Muellegr/Star_Gazer/Case/Pictures/CaseCutout_SimpleSide.png

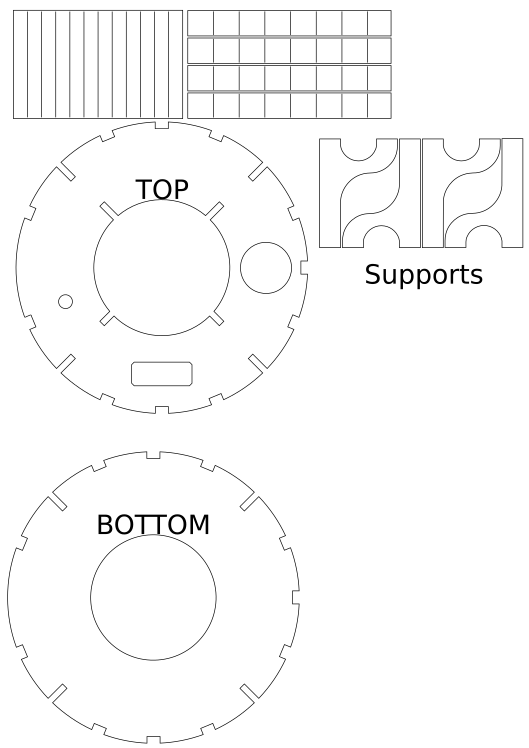
Case/Pictures/CaseCutout_SimpleSide.png
