Muellegr/Star_Gazer/Case/Pictures/IMG_20201006_191345.jpg

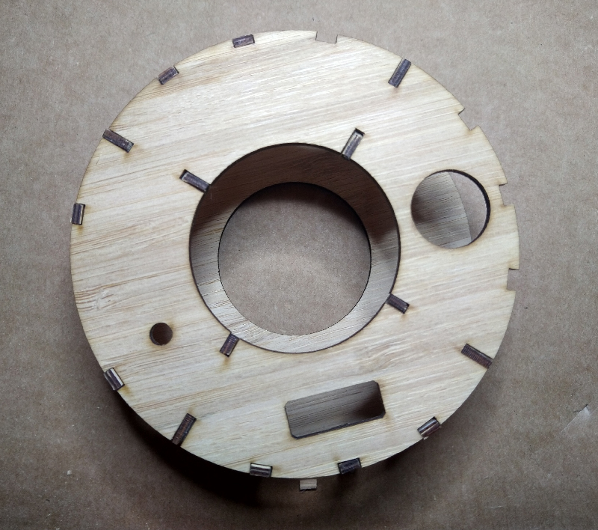
Case/Pictures/IMG_20201006_191345.jpg
