Muellegr/Star_Gazer/Case/Pictures/IMG_20201006_191352.jpg

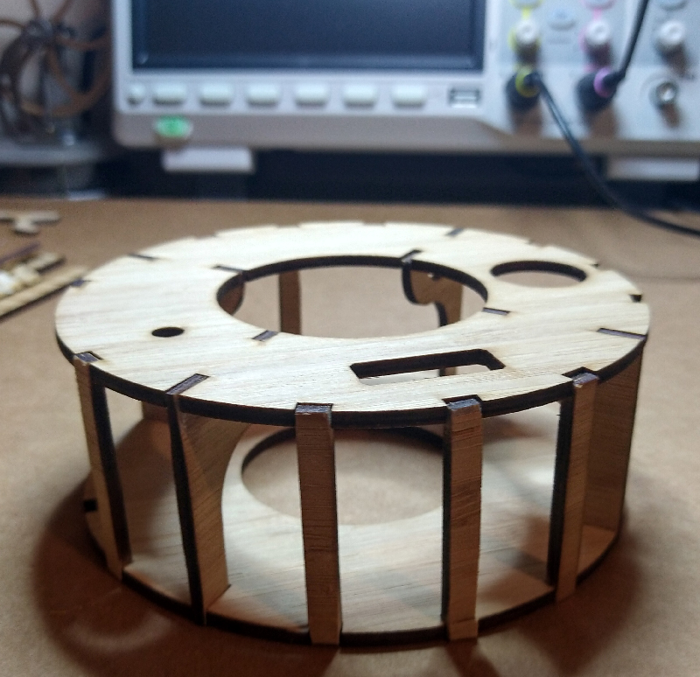
Case/Pictures/IMG_20201006_191352.jpg
