Muellegr/Star_Gazer/Documentation/Images/PCB Blank/IMG_20201009_194849.jpg

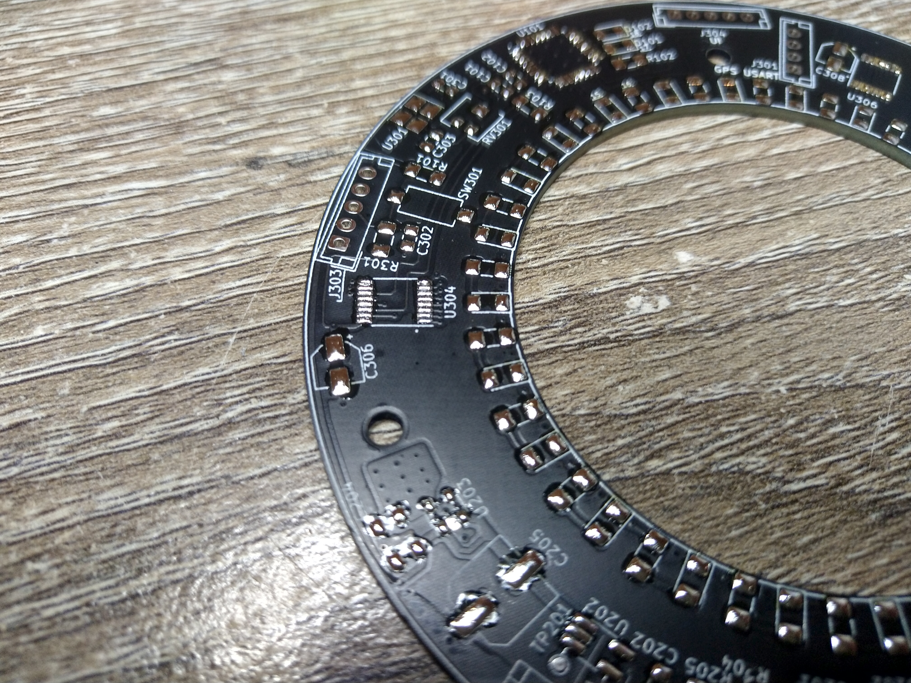
Documentation/Images/PCB Blank/IMG_20201009_194849.jpg
