Muellegr/Star_Gazer/Documentation/Images/PCB Blank/IMG_20201009_195733.jpg

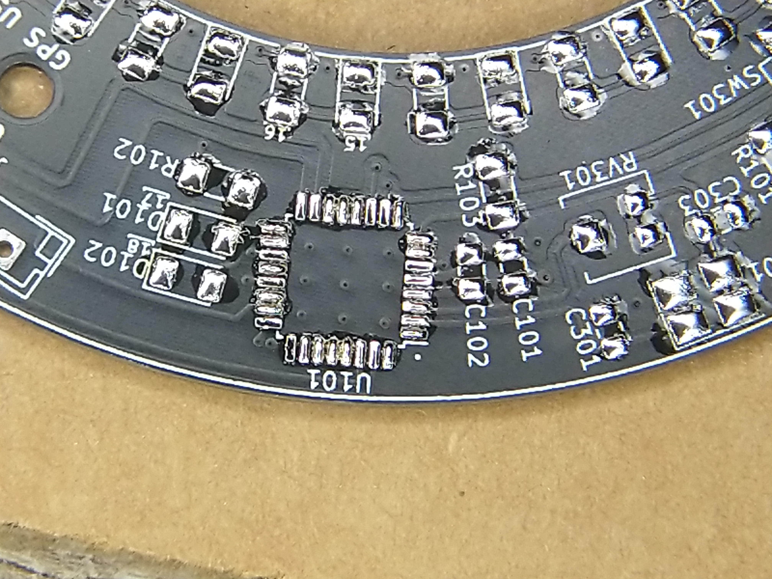
Documentation/Images/PCB Blank/IMG_20201009_195733.jpg
