Muellegr/Star_Gazer/Documentation/Images/PCB DESIGN/PCB_PLACEMENT_0.png

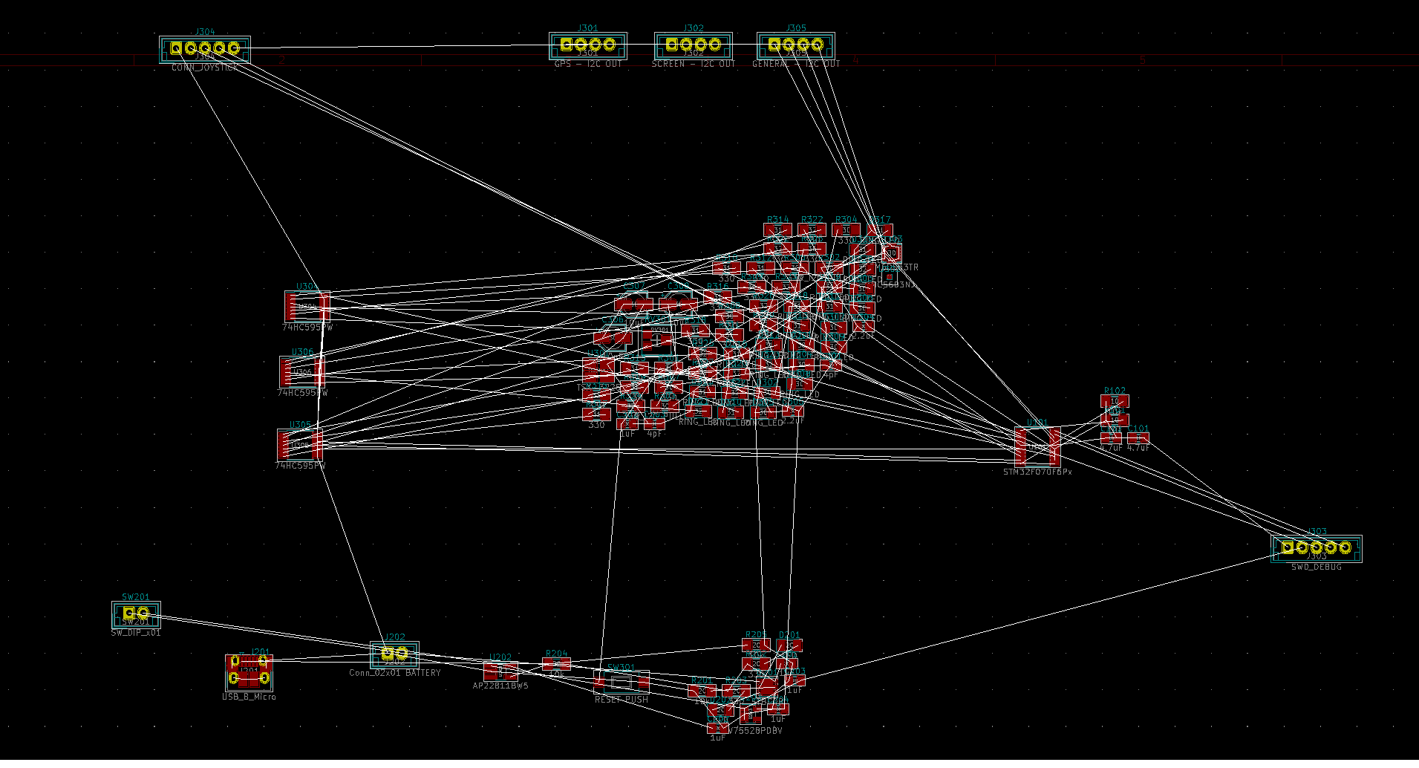
Documentation/Images/PCB DESIGN/PCB_PLACEMENT_0.png
