Muellegr/Star_Gazer/Documentation/Images/PCB DESIGN/PCB_PLACEMENT_1.png

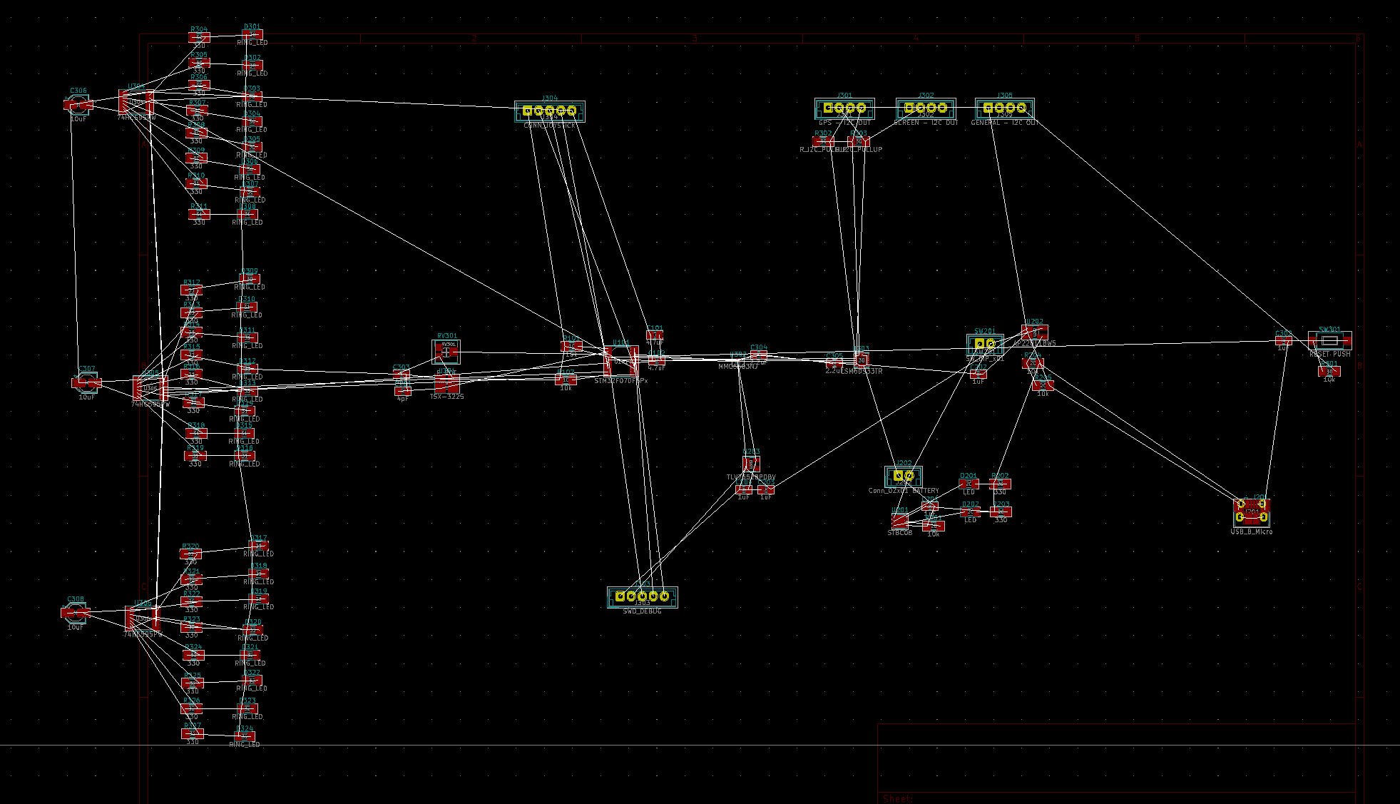
Documentation/Images/PCB DESIGN/PCB_PLACEMENT_1.png
