Muellegr/Star_Gazer/Documentation/Images/PCB DESIGN/PCB_PLACEMENT_RING.png

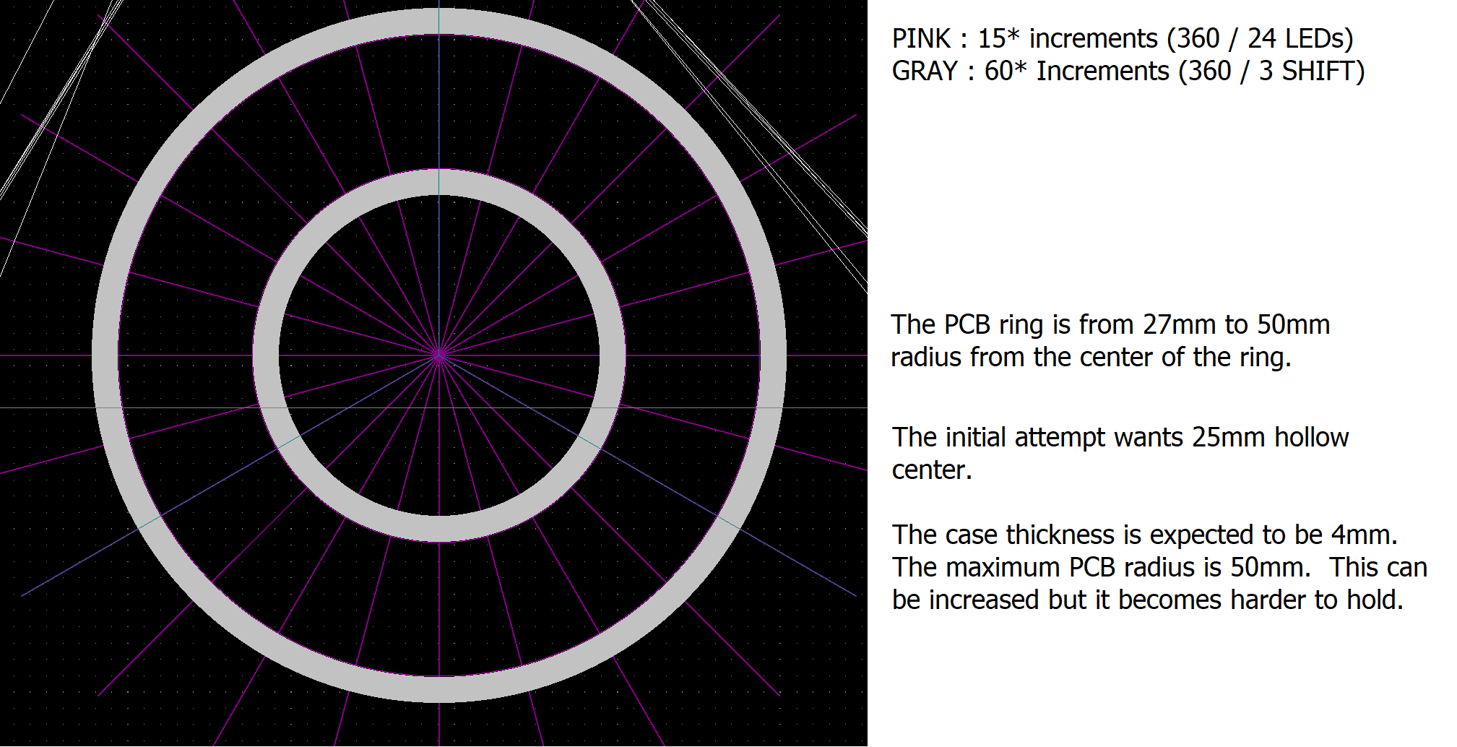
Documentation/Images/PCB DESIGN/PCB_PLACEMENT_RING.png
