Muellegr/Star_Gazer/Documentation/Images/PCB Melt/IMG_20201010_125346.jpg

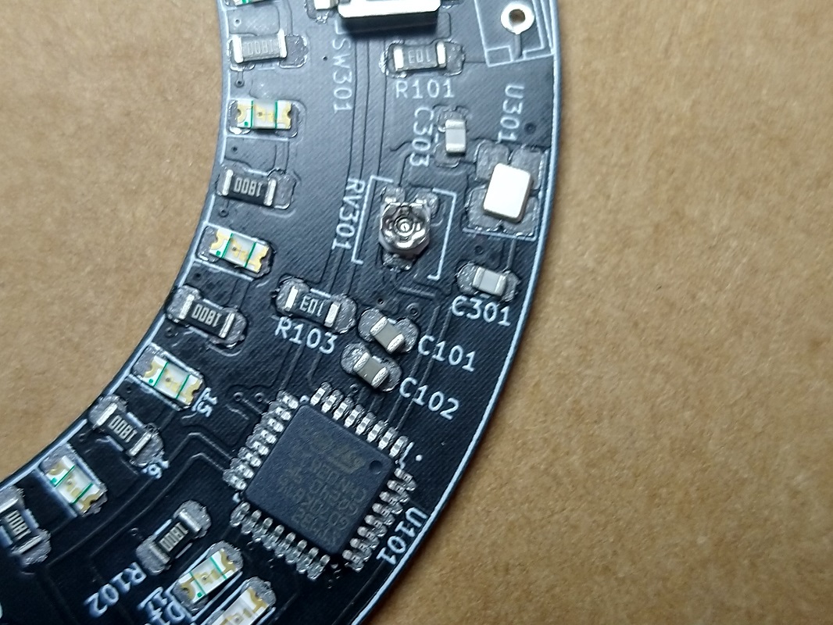
Documentation/Images/PCB Melt/IMG_20201010_125346.jpg
