Muellegr/Star_Gazer/Case/Pictures/Case_Failure.png

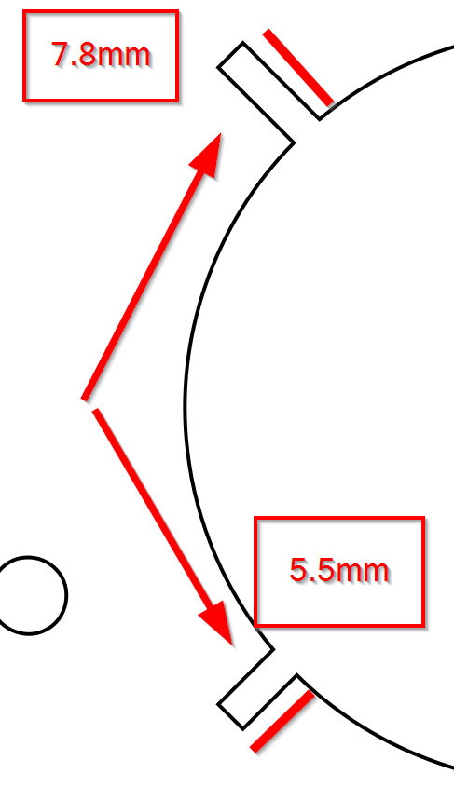
Case/Pictures/Case_Failure.png
