Muellegr/Star_Gazer/(threads)

Thread 1 (2020-09-07):

Feedback

ZachEnglish, 2020-09-07:
Battery Charging
LEDs at maximum current can sometimes be brighter than you desire (also take up more power for a battery powered device).
Especially for a device designed to be used at night, suggest testing out R values for R202 to observe brightness before commiting to a value.
Easy to swap later if it is an issue though.

Shift Registers
If you run a line from the output enable on the shift registers to a free I/O pin (didn't check to see if you have spare...), you could PWM your LEDs all at once that way. This loops to the comment earlier about LED brightness.

Magnometer
I think you have the power and ground pins backwards. VSA should be ground and VDD is power.

Microcontroller
There is a lot to dig into here and I haven't yet at all. Is the part you have in your schematic the same one you have a link to in your planning document?

Muellegr, 2020-09-08:
The battery charging LEDs will only be on when inside a building and connected to a proper power source.  Since they'll be inside a container with a sort of ribbed side, I want them to be bright enough to easily see.

I was going to wing the LED brightness, but now I wonder if I could get a good test in before I order parts.

Shift Register - Using output enable like that wasn't something I thought about.  The plan was to originally run the LEDs bright but keep them off most of the time.  I moved 'reset' over to a io pin so I could quickly turn it off.  I think using output enable is an upgrade if I can't find any negatives with it!

Magnometer - I'll have to double check.  I think I noticed that myself earlier and fixed it, though that may have been the crystal.  One of the tiny 4 square things.

MC - Oh boy that planning document is not the greatest.  I've moved over to tracking parts entirely within kicad, which is the same thing as on the wiki page.

The chip I'm using is the 'STM32F070F6P6TR'.  When I was initially planning things out I bounced between a bunch of different cortex chips as I slowly got a grasp on them. Decision paralysis got ahold of me so I went with the first chip I found that would do the job.

---
The schematic and part IDs are probably in their final form unless I find a mistake.  Big todo is to go in with a fine tooth comb on my power side and look for problems, polish info on what/why I did things here (otherwise I never will) and continue working on the layout.
