Muellegr/Star_Gazer/Documentation/StarGazer_Schematics.pdf

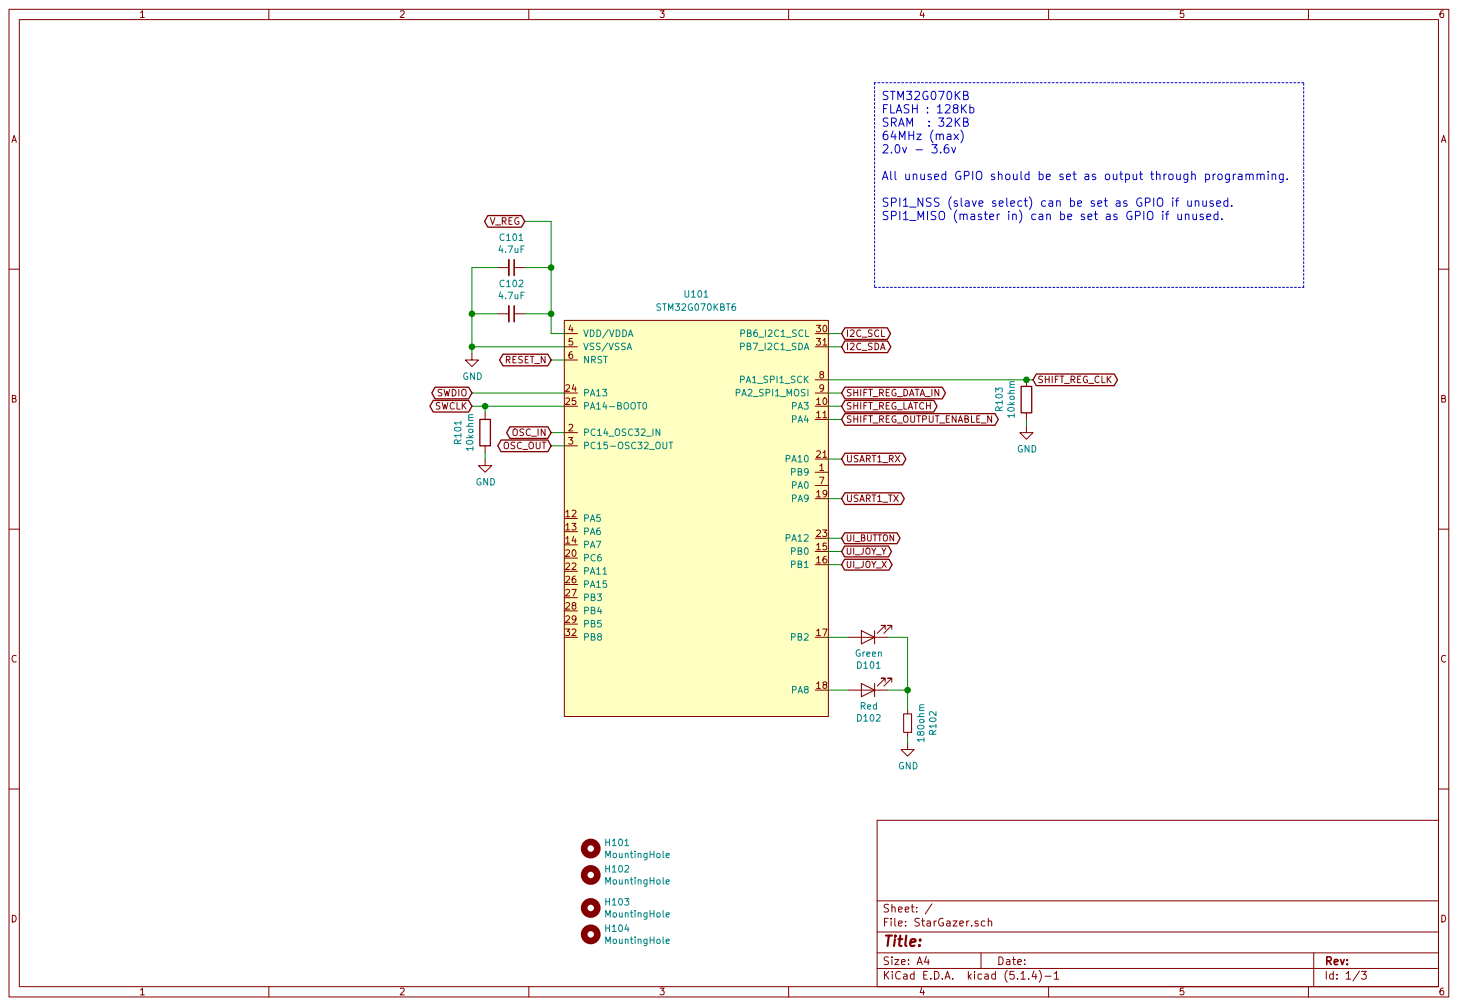
[picture p16: page 1]

All unused GPIO should be set as output through programming.

SPI1_NSS (slave select) can be set as GPIO if unused.
SPI1_MISO (master in) can be set as GPIO if unused.

Id: 1/3 Title: File: StarGazer.sch Sheet: /

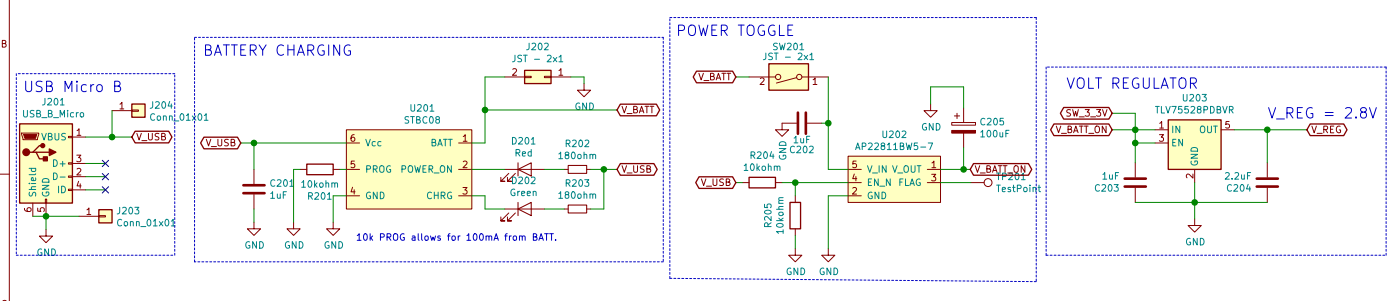
[picture p17: page 2]

10k PROG allows for 100mA from BATT. USB Micro B

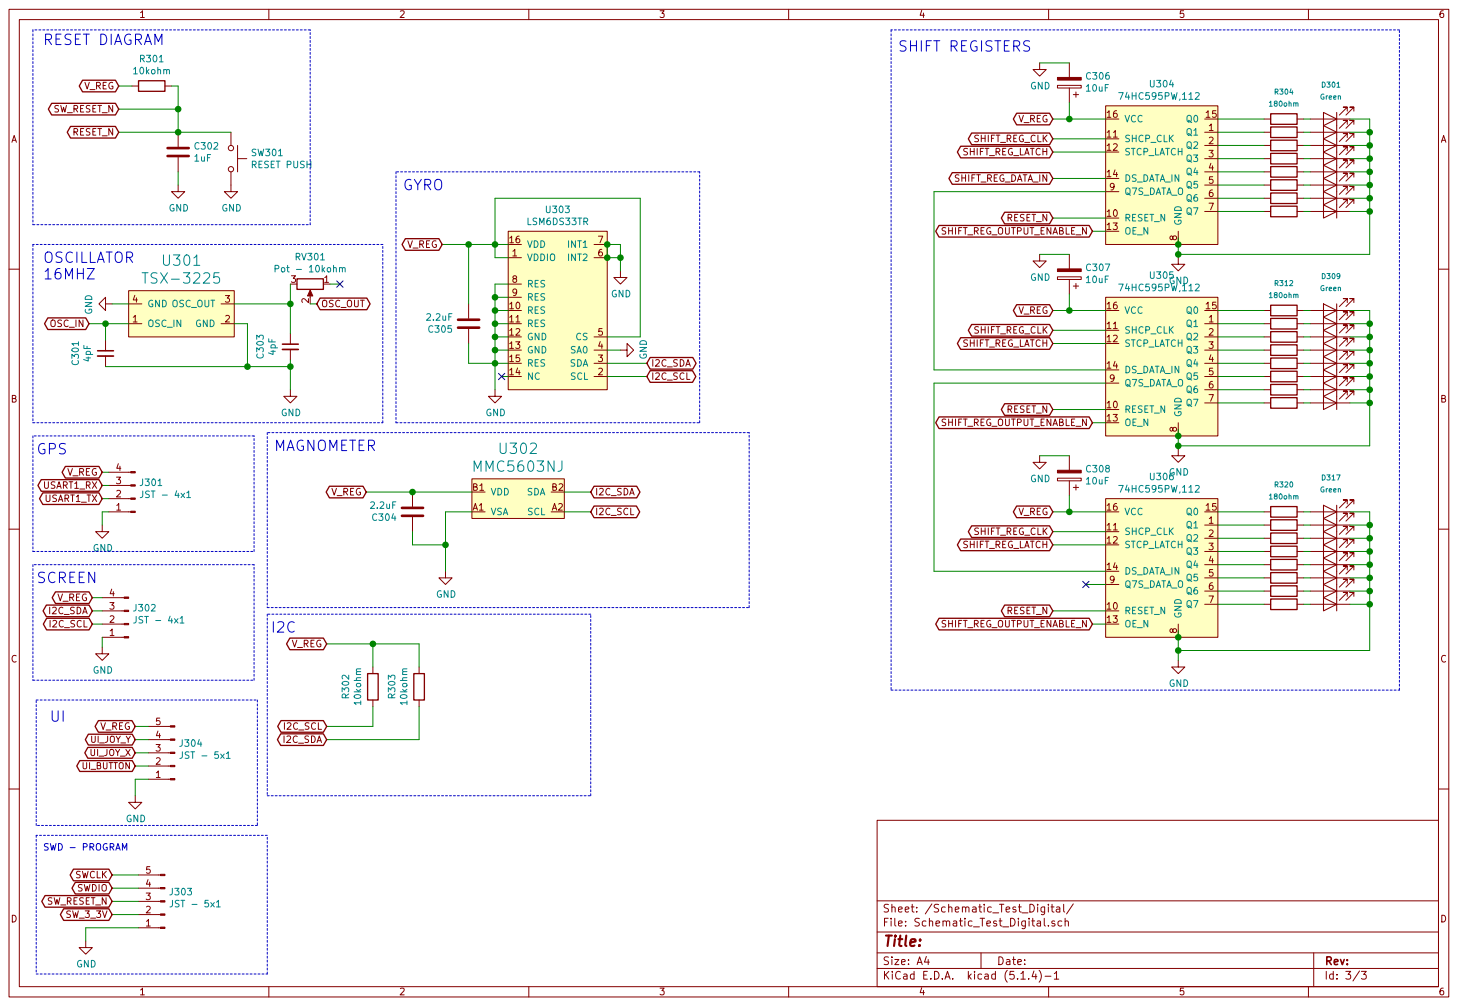
[picture p18: page 3]
