Muellegr/Star_Gazer/Documentation/StarGazer-B_CrtYd.pdf

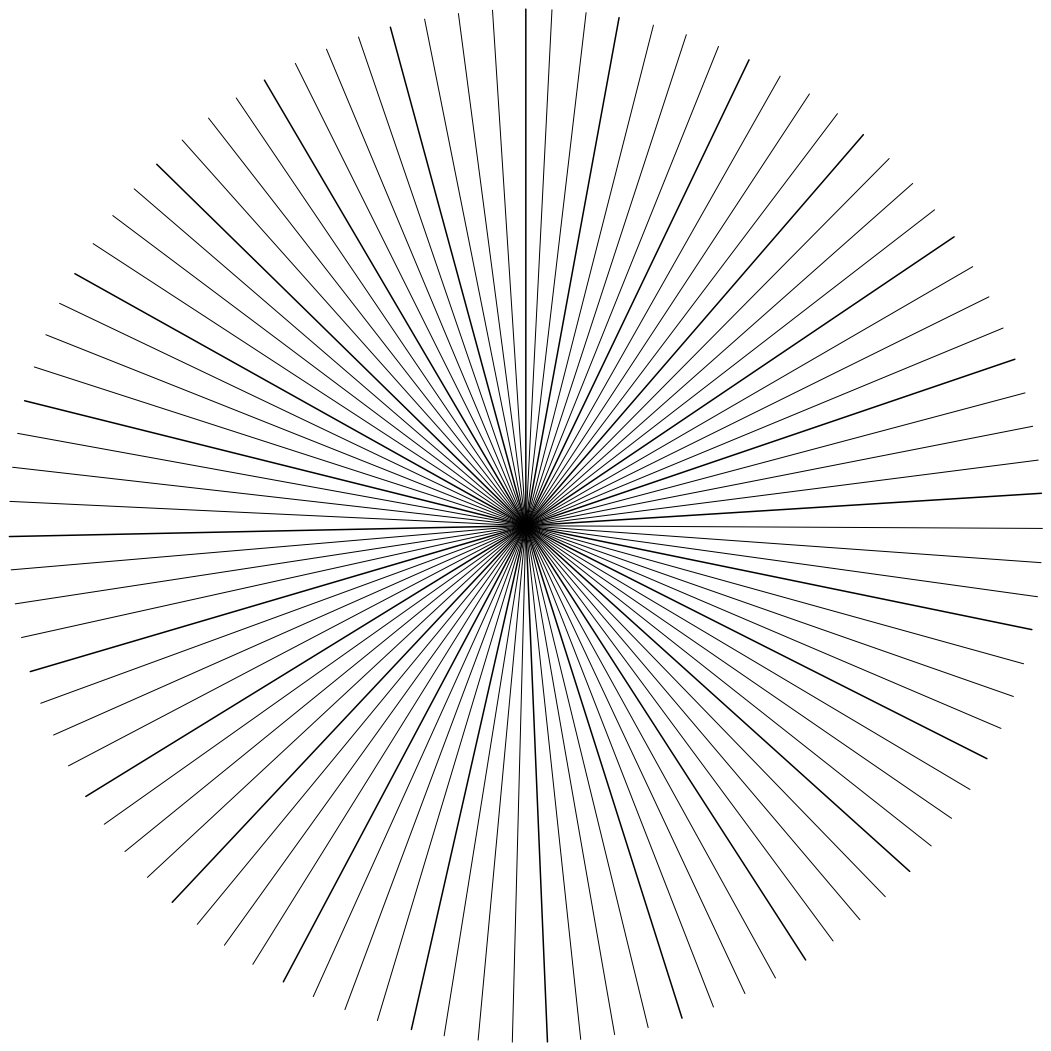
[picture p19: page 1]
