Muellegr/Star_Gazer/Documentation/StarGazer-B_Mask.pdf

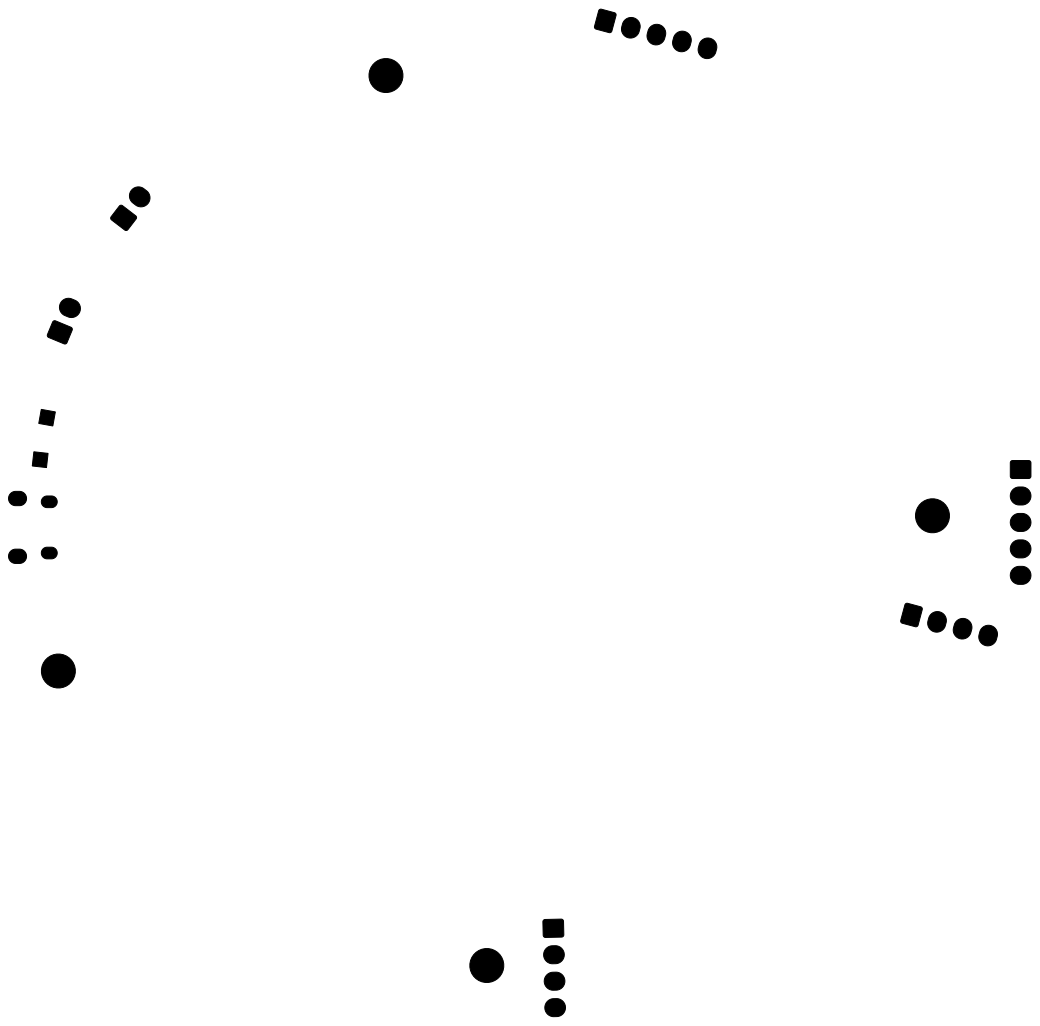
[picture p20: page 1]
