Muellegr/Star_Gazer/Documentation/StarGazer-B_SilkS.pdf

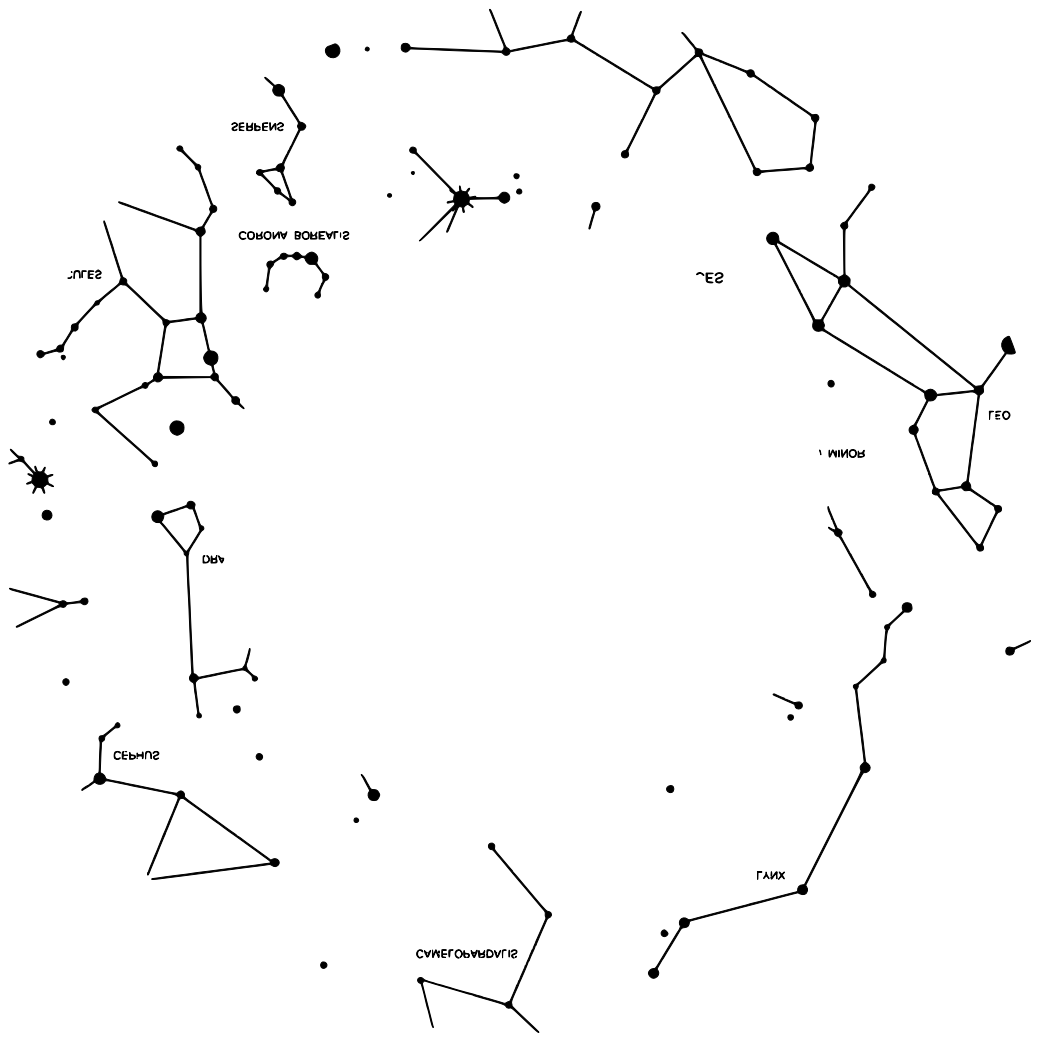
[picture p21: page 1]
