Muellegr/Star_Gazer/Documentation/StarGazer-Back.pdf

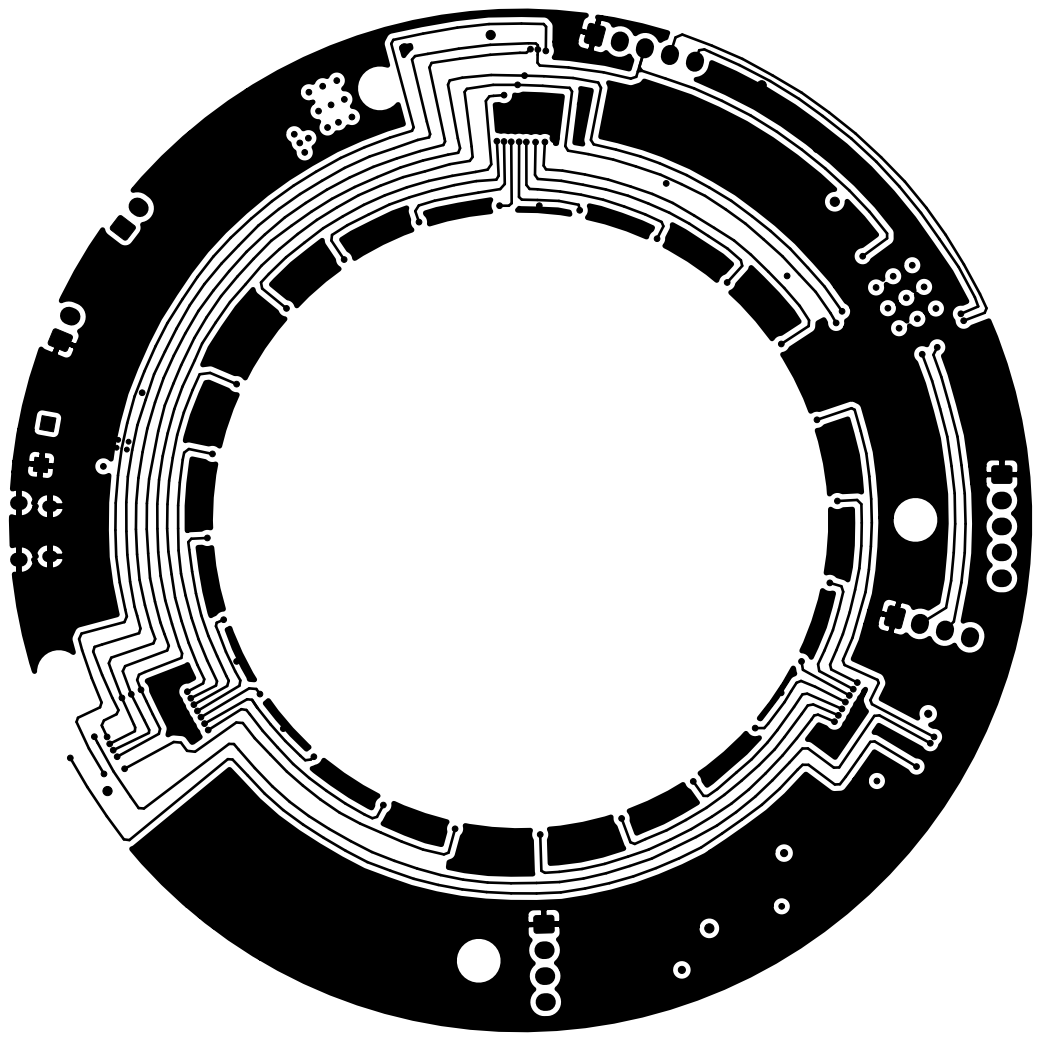
[picture p22: page 1]
