Muellegr/Star_Gazer/Documentation/StarGazer-F_CrtYd.pdf

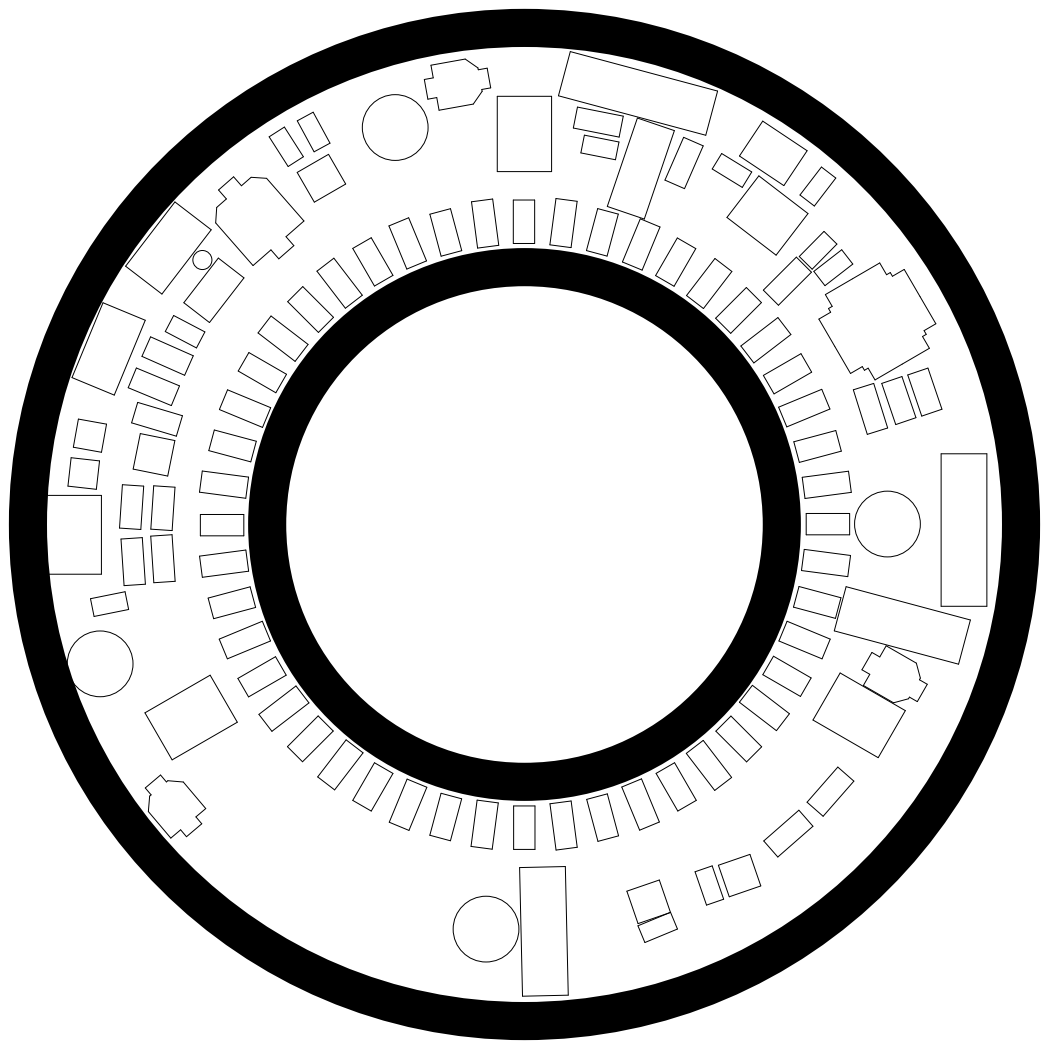
[picture p23: page 1]
