Muellegr/Star_Gazer/Documentation/StarGazer-F_Mask.pdf

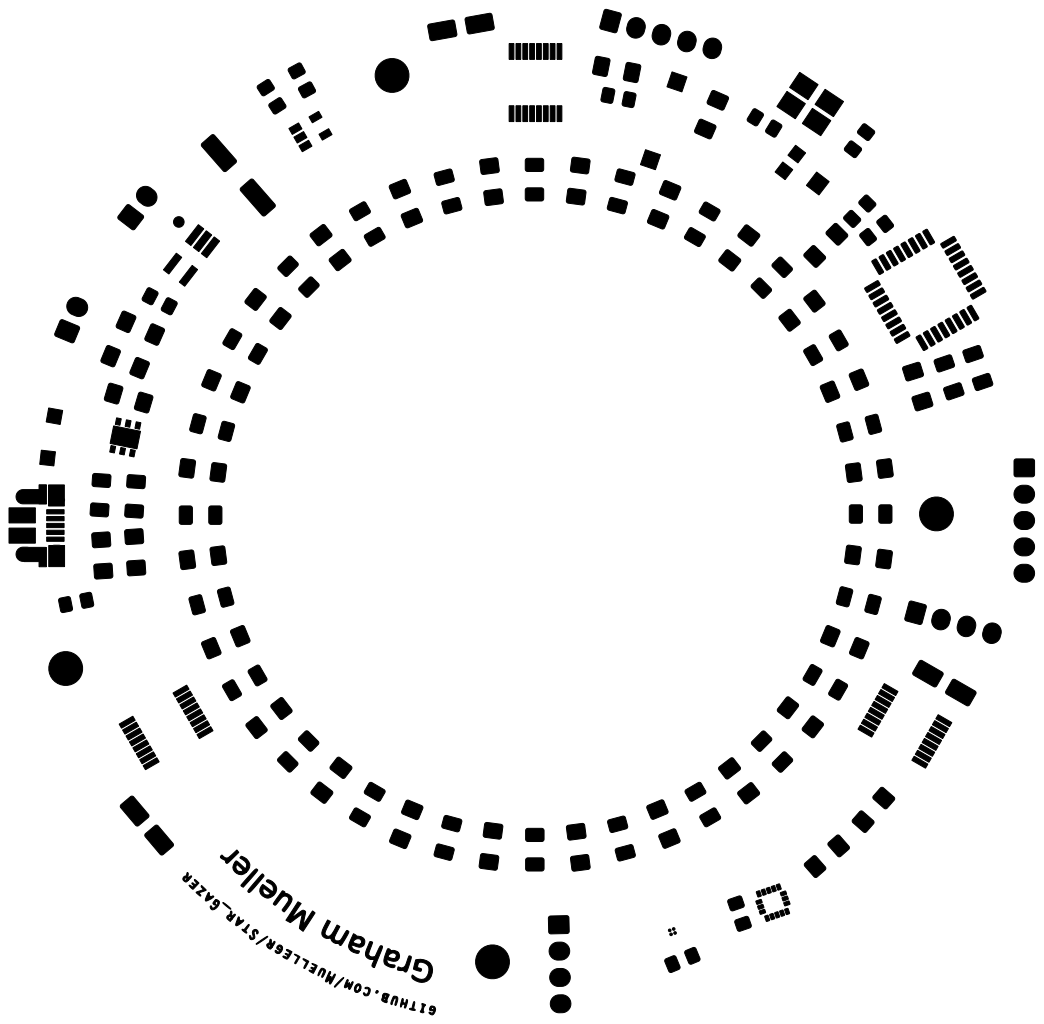
[picture p24: page 1]
