Muellegr/Star_Gazer/Documentation/StarGazer-F_Paste.pdf

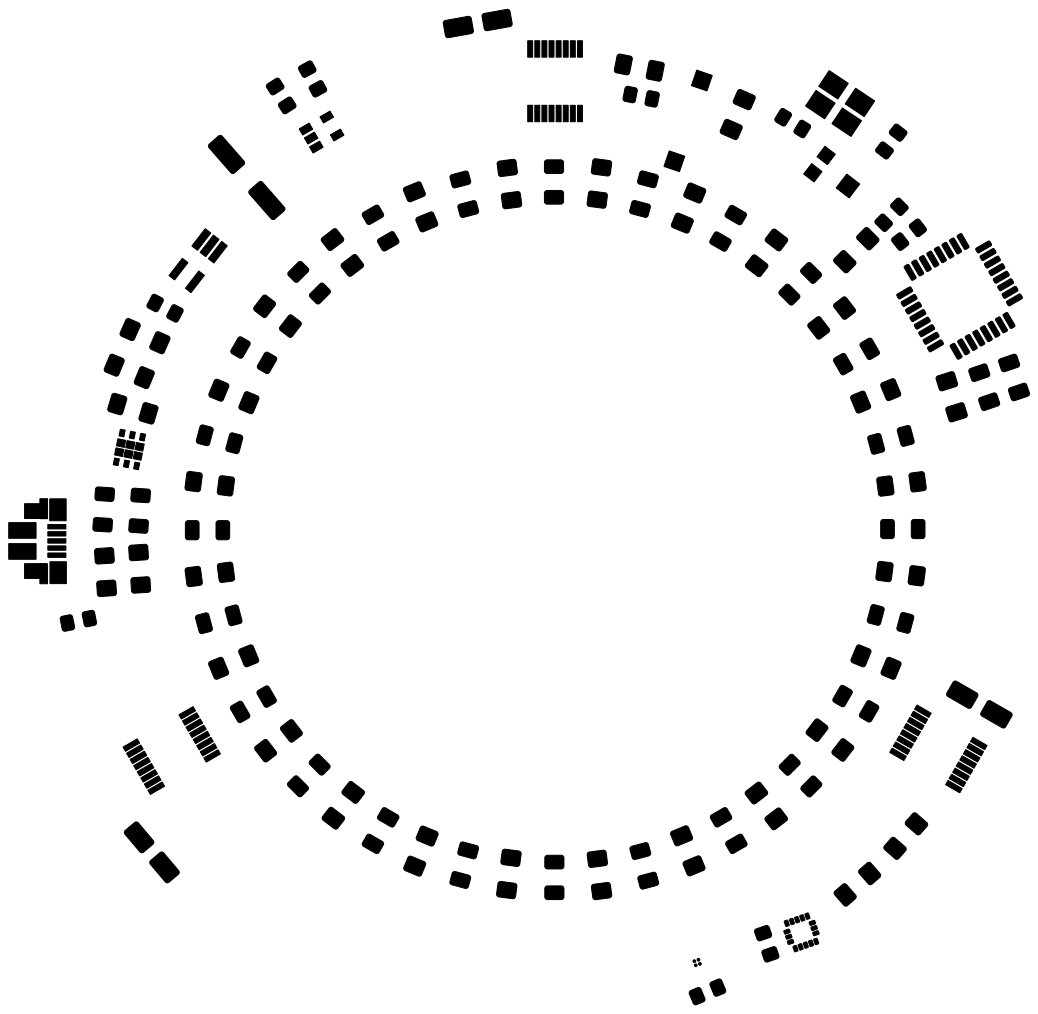
[picture p25: page 1]
