Muellegr/Star_Gazer/Documentation/StarGazer-F_SilkS.pdf

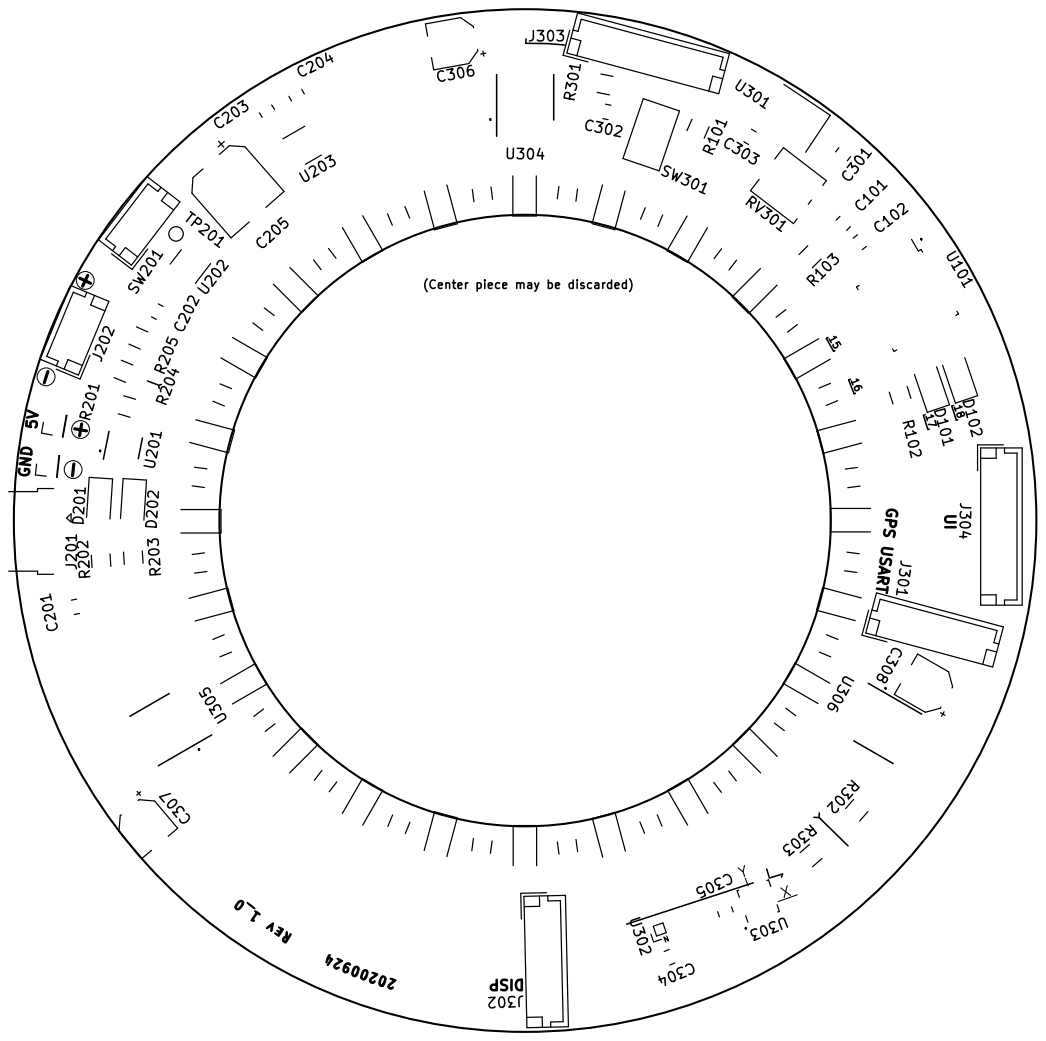
[picture p26: page 1]
