Muellegr/Star_Gazer/Documentation/StarGazer-Front.pdf

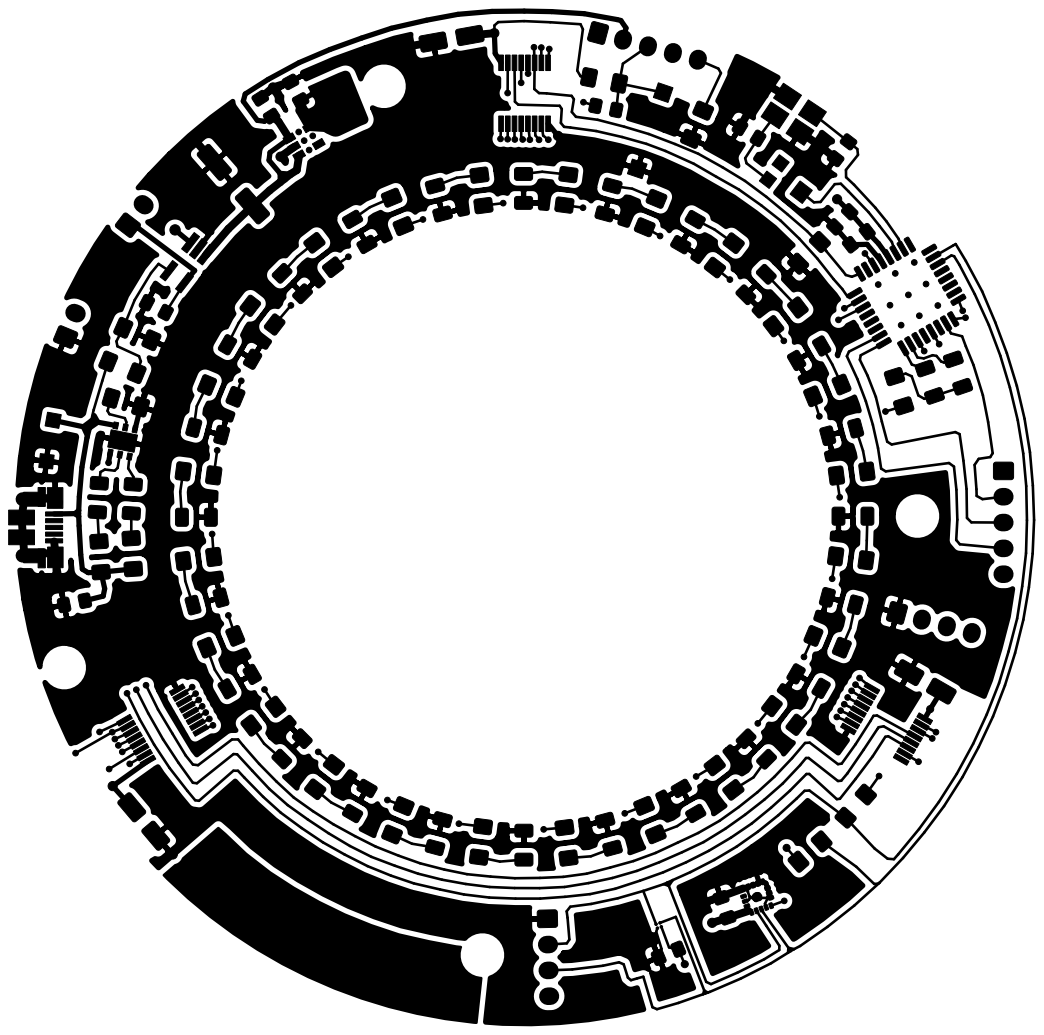
[picture p27: page 1]
