Muellegr/Star_Gazer/Documentation/StarGazer-In1_Cu.pdf

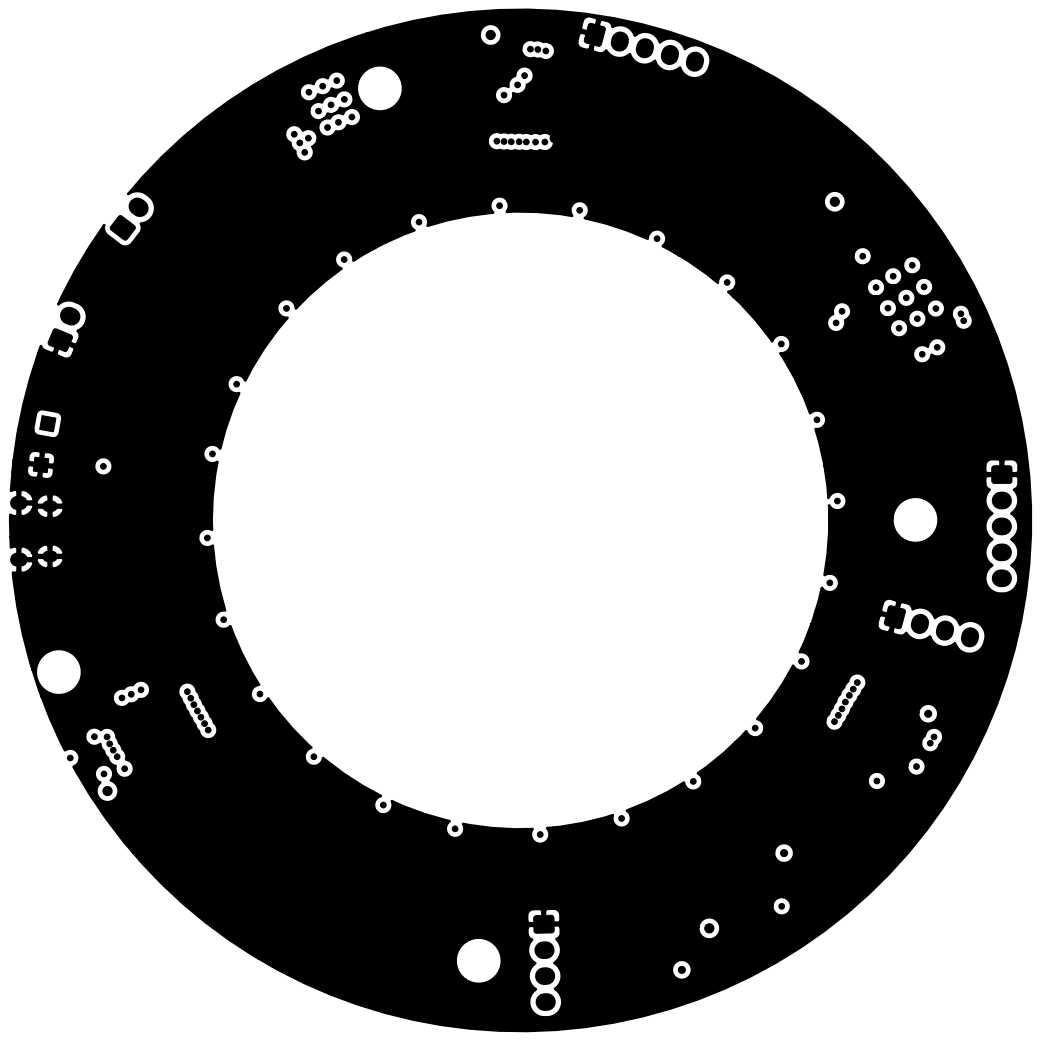
[picture p28: page 1]
