Muellegr/Star_Gazer/Documentation/StarGazer-In2_Cu.pdf

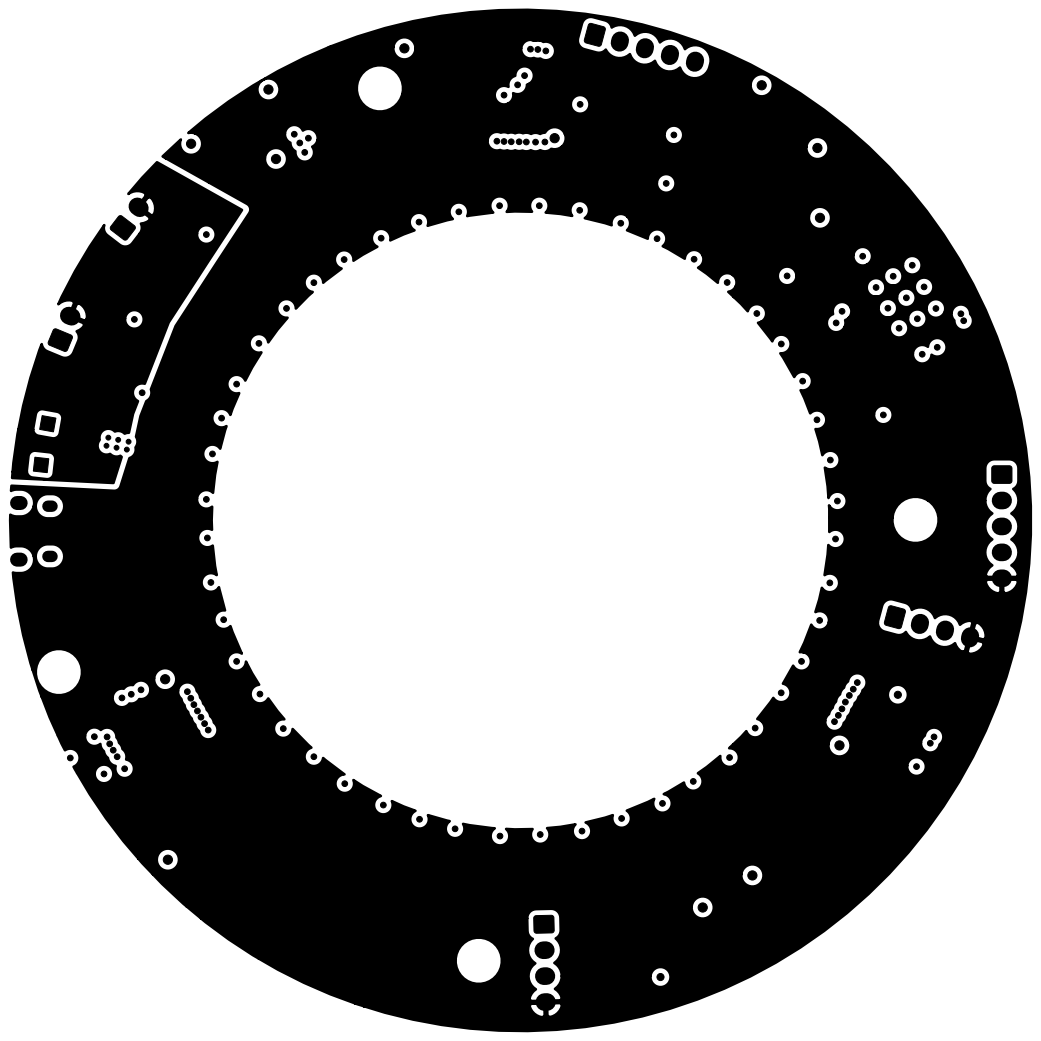
[picture p29: page 1]
