Muellegr/Star_Gazer/Kicad/StarGazer.kicad_pcb

## KiCad design Kicad/StarGazer.kicad_pcb (2020-10-15)

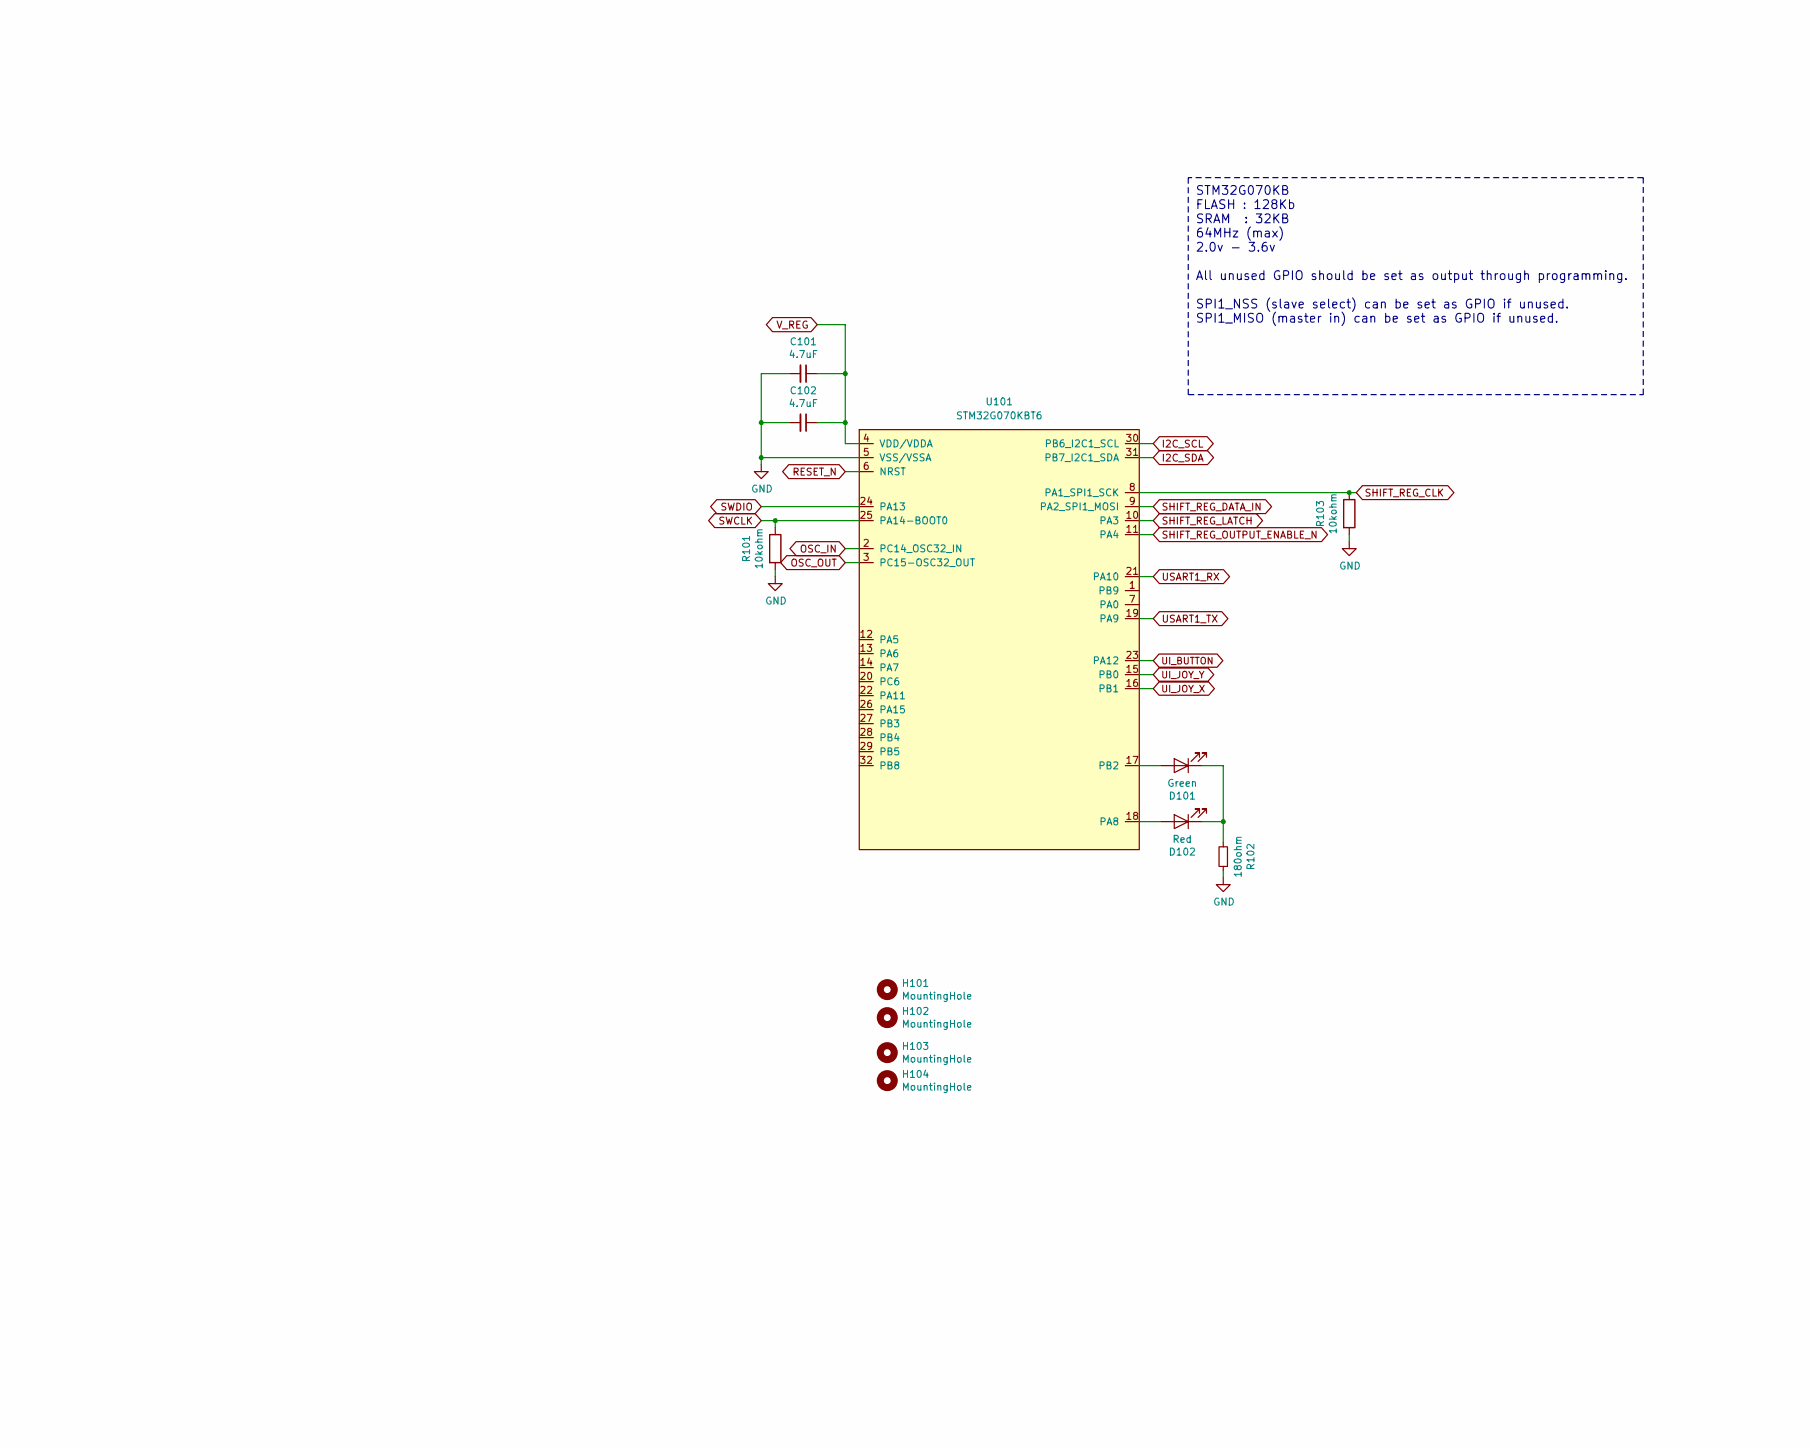
[picture p30: schematic StarGazer.sch, part in row 1, column 2]

Parts:
C101, C102: 4.7uF; C_0805_2012Metric_Pad1.15x1.40mm_HandSolder; part_name Capactitor - Bypass
D101: Green; D_1206_3216Metric; part_details Debug Light
D102: Red; D_1206_3216Metric; part_details Debug Light
H101, H102, H103, H104: MountingHole; MountingHole_3.2mm_M3; part_details DO_NOT_SHOW
R101, R103: 10kohm; R_1206_3216Metric_Pad1.42x1.75mm_HandSolder; part_name Resistor - Pull Up
R102: 180ohm; R_1206_3216Metric_Pad1.42x1.75mm_HandSolder; part_name Resistor - LED Status
U101: STM32G070KBT6; LQFP-32_7x7mm_P0.8mm; part_details 64Mhz Flash=128Kb, SRAM=32Kb

Connections:
GND: C101.2, C102.2, R101.2, R102.1, R103.2, U101.5 (VSS/VSSA); also elsewhere on the board
I2C_SCL: U101.30 (PB6_I2C1_SCL); also elsewhere on the board
I2C_SDA: U101.31 (PB7_I2C1_SDA); also elsewhere on the board
unnamed: D101.1 (K), D102.1 (K), R102.2
unnamed: D101.2 (A), U101.17 (PB2)
unnamed: D102.2 (A), U101.18 (PA8)
OSC_IN: U101.2 (PC14_OSC32_IN); also elsewhere on the board
OSC_OUT: U101.3 (PC15-OSC32_OUT); also elsewhere on the board
RESET_N: U101.6 (NRST); also elsewhere on the board
SHIFT_REG_CLK: R103.1, U101.8 (PA1_SPI1_SCK); also elsewhere on the board
SHIFT_REG_DATA_IN: U101.9 (PA2_SPI1_MOSI); also elsewhere on the board
SHIFT_REG_LATCH: U101.10 (PA3); also elsewhere on the board
SHIFT_REG_OUTPUT_ENABLE_N: U101.11 (PA4); also elsewhere on the board
SWCLK: R101.1, U101.25 (PA14-BOOT0); also elsewhere on the board
SWDIO: U101.24 (PA13); also elsewhere on the board
UI_BUTTON: U101.23 (PA12); also elsewhere on the board
UI_JOY_X: U101.16 (PB1); also elsewhere on the board
UI_JOY_Y: U101.15 (PB0); also elsewhere on the board
USART1_RX: U101.21 (PA10); also elsewhere on the board
USART1_TX: U101.19 (PA9); also elsewhere on the board
V_REG: C101.1, C102.1, U101.4 (VDD/VDDA); also elsewhere on the board

Notes on the sheet:
STM32G070KB FLASH : 128Kb SRAM : 32KB 64MHz (max) 2.0v - 3.6v All unused GPIO should be set as output through programming. SPI1_NSS (slave select) can be set as GPIO if unused. SPI1_MISO (master in) can be set as GPIO if unused.

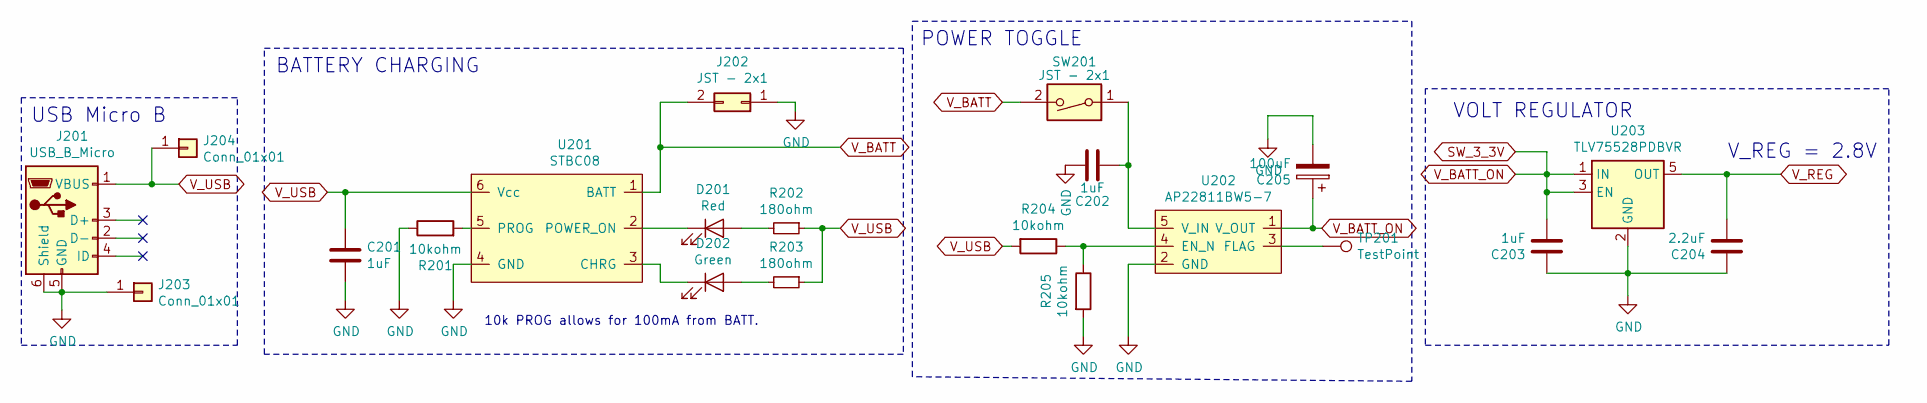
[picture p31: schematic Schematic_Test_Power.sch]

Parts:
C201, C202, C203: 1uF; C_0805_2012Metric_Pad1.15x1.40mm_HandSolder; part_name Capactitor - Bypass
C204: 2.2uF; C_0805_2012Metric_Pad1.15x1.40mm_HandSolder; part_name Capactitor - Bypass
C205: 100uF; CP_Elec_6.3x5.2; part_name Capactitor - Bypass
D201: Red; D_1206_3216Metric; part_details Red when charging error
D202: Green; D_1206_3216Metric; part_details Green when charging
J201: USB_B_Micro; USB_Micro-B_Amphenol_10103594-0001LF_Horizontal; part_name USB-B Micro
J202: JST - 2x1; JST_EH_B2B-EH-A_1x02_P2.50mm_Vertical; part_name Battery Connector
J203, J204: Conn_01x01; PinHeader_1x01_P2.00mm_Vertical; part_details DO_NOT_SHOW
R201: 10kohm; R_1206_3216Metric_Pad1.42x1.75mm_HandSolder; part_details Battery Program for 100mA recharge rate.
R202, R203: 180ohm; R_1206_3216Metric_Pad1.42x1.75mm_HandSolder; part_name Resistor - LED Status
R204, R205: 10kohm; R_1206_3216Metric_Pad1.42x1.75mm_HandSolder; part_name Resistor - Pull Up
SW201: JST - 2x1; JST_EH_B2B-EH-A_1x02_P2.50mm_Vertical; part_details Power toggle
TP201: TestPoint; TestPoint_Pad_D1.0mm; part_details Test point for U202 error (low imp. on 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
U201: STBC08; DFN-6-1EP_3x3mm_P0.95mm_EP1.7x2.6mm; part_name Lithium Ion Battery Charging IC
U202: AP22811BW5-7; TSOT-23-5_HandSoldering; part_details Battery protection switch
U203: TLV75528PDBVR; SOT-23-5; part_details 2.8v 500mA, 230mV~ dropout

Connections:
GND: C201.2, C202.2, C203.1, C204.1, C205.2, J201.5 (GND), J201.6 (Shield), J202.1, J203.1, R201.1, R205.2, U201.4 (GND), U202.2 (GND), U203.2 (GND); also elsewhere on the board
unnamed: C202.1, SW201.1, U202.5 (V_IN)
unnamed: D201.1 (K), U201.2 (POWER_ON)
unnamed: D201.2 (A), R202.2
unnamed: D202.1 (K), U201.3 (CHRG)
unnamed: D202.2 (A), R203.2
unnamed: R201.2, U201.5 (PROG)
unnamed: R204.1, R205.1, U202.4 (EN_N)
unnamed: TP201.1, U202.3 (FLAG)
SW_3_3V: C203.2, C205.1, U202.1 (V_OUT), U203.1 (IN), U203.3 (EN); also elsewhere on the board
V_BATT: J202.2, SW201.2, U201.1 (BATT)
V_REG: C204.2, U203.5 (OUT); also elsewhere on the board
V_USB: C201.1, J201.1 (VBUS), J204.1, R202.1, R203.1, R204.2, U201.6 (Vcc)

Notes on the sheet:
10k PROG allows for 100mA from BATT.
BATTERY CHARGING
POWER TOGGLE
VOLT REGULATOR
V_REG = 2.8V
USB Micro B

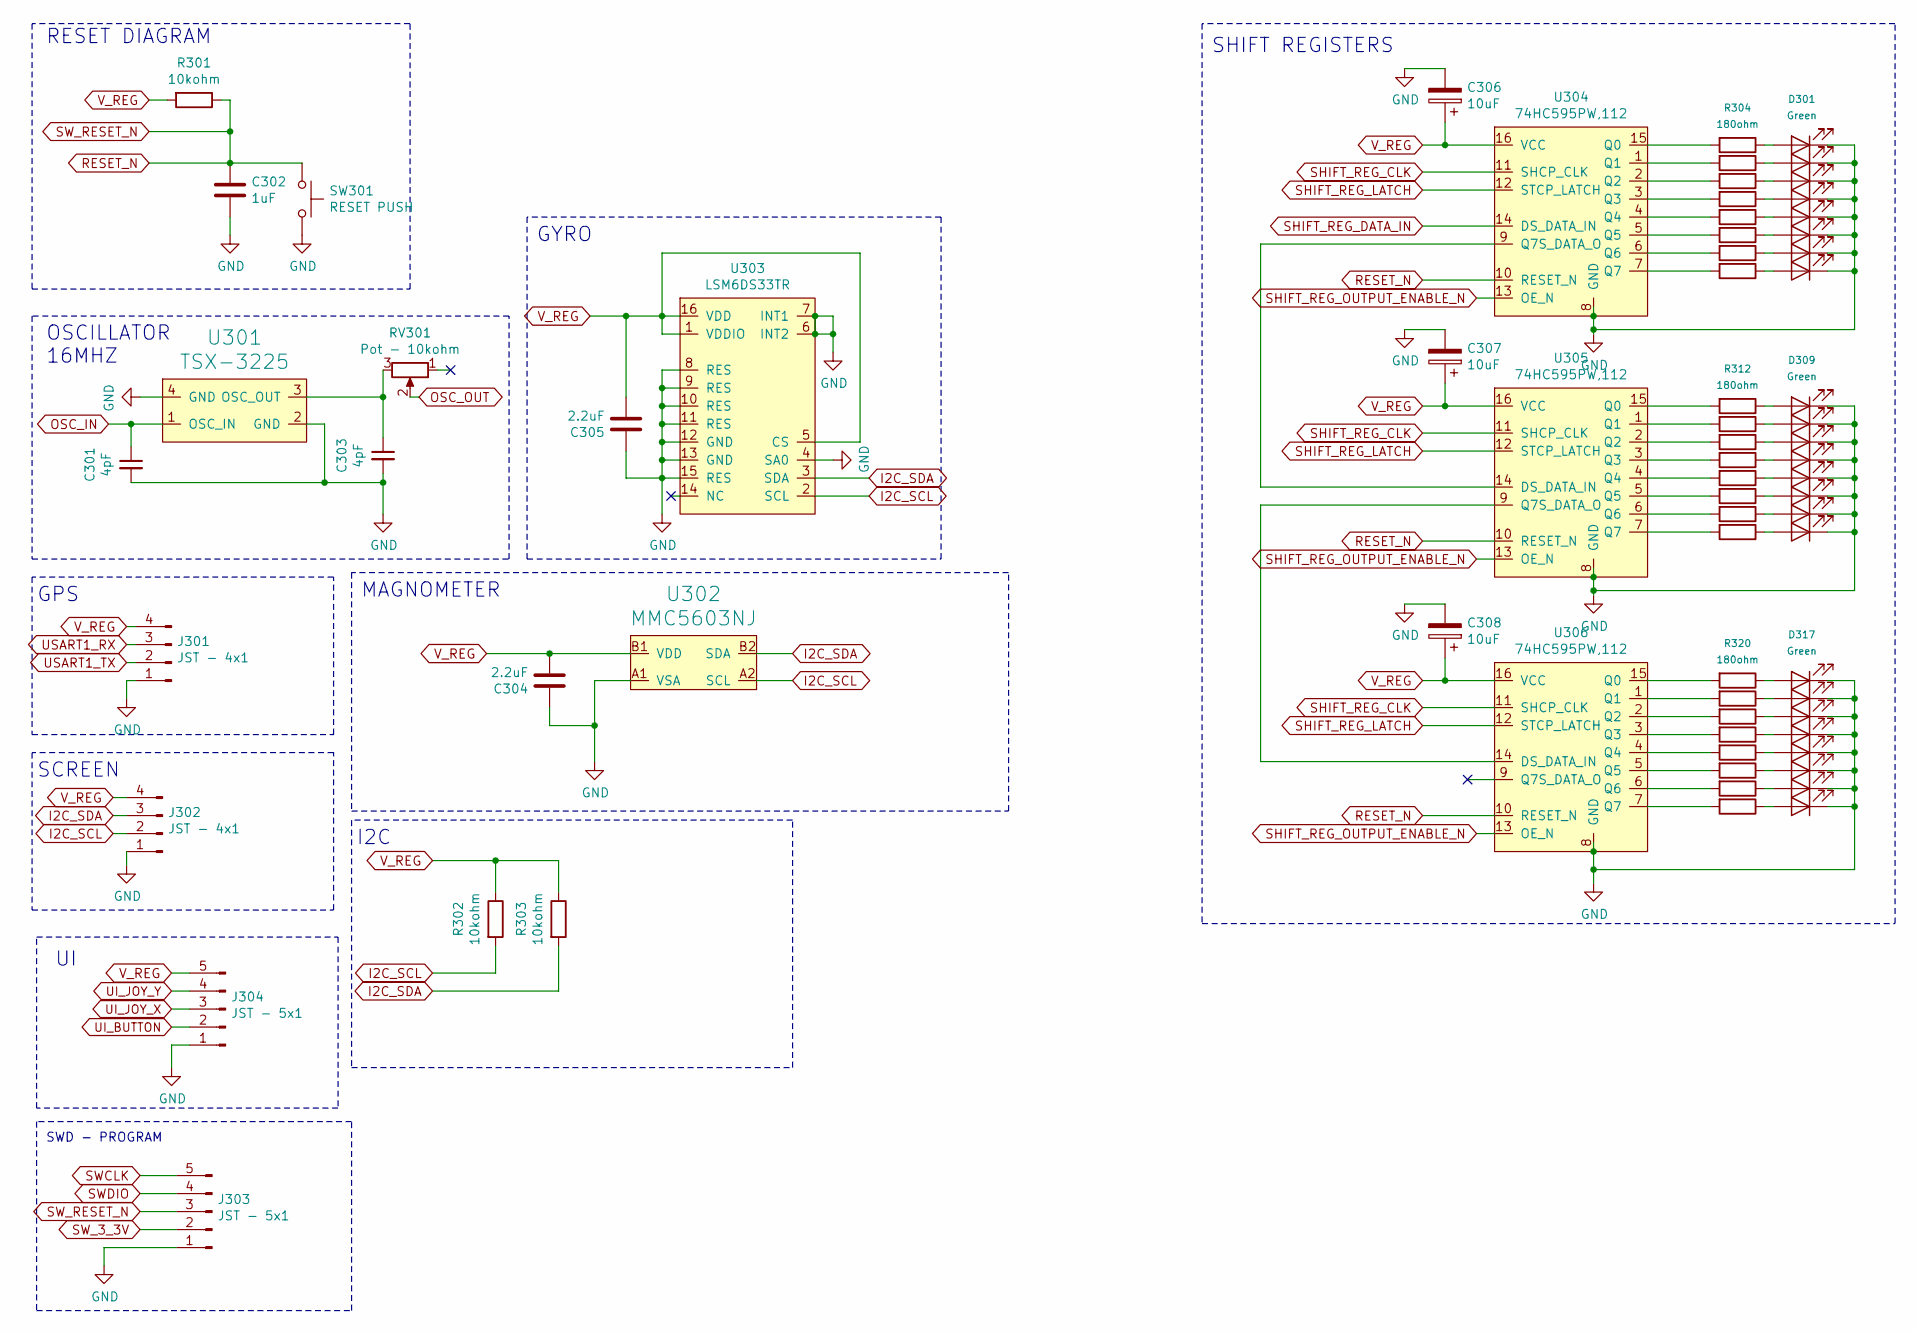
[picture p32: schematic Schematic_Test_Digital.sch]

Parts:
C301, C303: 4pF; C_0805_2012Metric_Pad1.15x1.40mm_HandSolder; part_name Capactitor - Crystal
C302: 1uF; C_0805_2012Metric_Pad1.15x1.40mm_HandSolder; part_name Capactitor - Bypass
C304, C305: 2.2uF; C_0805_2012Metric_Pad1.15x1.40mm_HandSolder; part_name Capactitor - Bypass
C306, C307, C308: 10uF; CP_Elec_4x3; part_name Capactitor - Bypass
D301, D302, D303, D304, D305, D306, D307, D308, D309, D310, D311, D312, D313, D314, D315, D316, D317, D318, D319, D320, D321, D322, D323, D324: Green; D_1206_3216Metric; part_name LED - Ring Green
J301: JST - 4x1; JST_EH_B4B-EH-A_1x04_P2.50mm_Vertical; part_details USART
J302: JST - 4x1; JST_EH_B4B-EH-A_1x04_P2.50mm_Vertical; part_details I2C
J303: JST - 5x1; JST_EH_B5B-EH-A_1x05_P2.50mm_Vertical; part_name SWD Program Connector
J304: JST - 5x1; JST_EH_B5B-EH-A_1x05_P2.50mm_Vertical; part_details I2C
R301, R302, R303: 10kohm; R_1206_3216Metric_Pad1.42x1.75mm_HandSolder; part_name Resistor - Pull Up
R304, R305, R306, R307, R308, R309, R310, R311, R312, R313, R314, R315, R316, R317, R318, R319, R320, R321, R322, R323, R324, R325, R326, R327: 180ohm; R_1206_3216Metric_Pad1.42x1.75mm_HandSolder; part_details LED dropout: 2v. V_REG is 2.8v. 0.8/180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
RV301: Pot - 10kohm; 35WR10KLFTR; part_details Adjustable external clock resistor.
SW301: RESET PUSH; SW_SPST_CK_RS282G05A3; part_name Switch - Reset (internal)
U301: TSX-3225; Crystal_SMD_SeikoEpson_TSX3225-4Pin_3.2x2.5mm_HandSoldering; part_name 16MHz Crystal
U302: MMC5603NJ; BGA_2_2; part_name Magnometer
U303: LSM6DS33TR; LGA-16_3x3mm_P0.5mm_LayoutBorder3x5y; part_name 6-axis Gyrometer
U304, U305, U306: 74HC595PW,112; TSSOP-16_4.4x5mm_P0.65mm; part_name Shift Register

Connections:
GND: C301.2, C302.2, C303.2, C304.1, C305.1, C306.2, C307.2, C308.2, D301.1 (K), D302.1 (K), D303.1 (K), D304.1 (K), D305.1 (K), D306.1 (K), D307.1 (K), D308.1 (K), D309.1 (K), D310.1 (K), D311.1 (K), D312.1 (K), D313.1 (K), D314.1 (K), D315.1 (K), D316.1 (K), D317.1 (K), D318.1 (K), D319.1 (K), D320.1 (K), D321.1 (K), D322.1 (K), D323.1 (K), D324.1 (K), J301.1, J302.1, J303.1, J304.1, SW301.2, U301.2 (GND), U301.4 (GND), U302.A1 (VSA), U303.4 (SA0), U303.6 (INT2), U303.7 (INT1), U303.8 (RES), U303.9 (RES), U303.10 (RES), U303.11 (RES), U303.12 (GND), U303.13 (GND), U303.15 (RES), U304.8 (GND), U305.8 (GND), U306.8 (GND); also elsewhere on the board
I2C_SCL: J302.2, R302.2, U302.A2 (SCL), U303.2 (SCL); also elsewhere on the board
I2C_SDA: J302.3, R303.2, U302.B2 (SDA), U303.3 (SDA); also elsewhere on the board
unnamed: C303.1, RV301.3, U301.3 (OSC_OUT)
unnamed: D301.2 (A), R304.1
unnamed: D302.2 (A), R305.1
unnamed: D303.2 (A), R306.1
unnamed: D304.2 (A), R307.1
unnamed: D305.2 (A), R308.1
unnamed: D306.2 (A), R309.1
unnamed: D307.2 (A), R310.1
unnamed: D308.2 (A), R311.1
unnamed: D309.2 (A), R312.1
unnamed: D310.2 (A), R313.1
unnamed: D311.2 (A), R314.1
unnamed: D312.2 (A), R315.1
unnamed: D313.2 (A), R316.1
unnamed: D314.2 (A), R317.1
unnamed: D315.2 (A), R318.1
unnamed: D316.2 (A), R319.1
unnamed: D317.2 (A), R320.1
unnamed: D318.2 (A), R321.1
unnamed: D319.2 (A), R322.1
unnamed: D320.2 (A), R323.1
unnamed: D321.2 (A), R324.1
unnamed: D322.2 (A), R325.1
unnamed: D323.2 (A), R326.1
unnamed: D324.2 (A), R327.1
unnamed: R304.2, U304.15 (Q0)
unnamed: R305.2, U304.1 (Q1)
unnamed: R306.2, U304.2 (Q2)
unnamed: R307.2, U304.3 (Q3)
unnamed: R308.2, U304.4 (Q4)
unnamed: R309.2, U304.5 (Q5)
unnamed: R310.2, U304.6 (Q6)
unnamed: R311.2, U304.7 (Q7)
unnamed: R312.2, U305.15 (Q0)
unnamed: R313.2, U305.1 (Q1)
unnamed: R314.2, U305.2 (Q2)
unnamed: R315.2, U305.3 (Q3)
unnamed: R316.2, U305.4 (Q4)
unnamed: R317.2, U305.5 (Q5)
unnamed: R318.2, U305.6 (Q6)
unnamed: R319.2, U305.7 (Q7)
unnamed: R320.2, U306.15 (Q0)
unnamed: R321.2, U306.1 (Q1)
unnamed: R322.2, U306.2 (Q2)
unnamed: R323.2, U306.3 (Q3)
unnamed: R324.2, U306.4 (Q4)
unnamed: R325.2, U306.5 (Q5)
unnamed: R326.2, U306.6 (Q6)
unnamed: R327.2, U306.7 (Q7)
unnamed: U304.9 (Q7S_DATA_O), U305.14 (DS_DATA_IN)
unnamed: U305.9 (Q7S_DATA_O), U306.14 (DS_DATA_IN)
OSC_IN: C301.1, U301.1 (OSC_IN); also elsewhere on the board
OSC_OUT: RV301.2; also elsewhere on the board
RESET_N: C302.1, J303.3, R301.1, SW301.1, U304.10 (RESET_N), U305.10 (RESET_N), U306.10 (RESET_N); also elsewhere on the board
SHIFT_REG_CLK: U304.11 (SHCP_CLK), U305.11 (SHCP_CLK), U306.11 (SHCP_CLK); also elsewhere on the board
SHIFT_REG_DATA_IN: U304.14 (DS_DATA_IN); also elsewhere on the board
SHIFT_REG_LATCH: U304.12 (STCP_LATCH), U305.12 (STCP_LATCH), U306.12 (STCP_LATCH); also elsewhere on the board
SHIFT_REG_OUTPUT_ENABLE_N: U304.13 (OE_N), U305.13 (OE_N), U306.13 (OE_N); also elsewhere on the board
SWCLK: J303.5; also elsewhere on the board
SWDIO: J303.4; also elsewhere on the board
SW_3_3V: J303.2; also elsewhere on the board
UI_BUTTON: J304.2; also elsewhere on the board
UI_JOY_X: J304.3; also elsewhere on the board
UI_JOY_Y: J304.4; also elsewhere on the board
USART1_RX: J301.3; also elsewhere on the board
USART1_TX: J301.2; also elsewhere on the board
V_REG: C304.2, C305.2, C306.1, C307.1, C308.1, J301.4, J302.4, J304.5, R301.2, R302.1, R303.1, U302.B1 (VDD), U303.1 (VDDIO), U303.5 (CS), U303.16 (VDD), U304.16 (VCC), U305.16 (VCC), U306.16 (VCC); also elsewhere on the board

Notes on the sheet:
OSCILLATOR 16MHZ
SHIFT REGISTERS
SCREEN
I2C
GYRO
RESET DIAGRAM
SWD - PROGRAM
GPS
MAGNOMETER

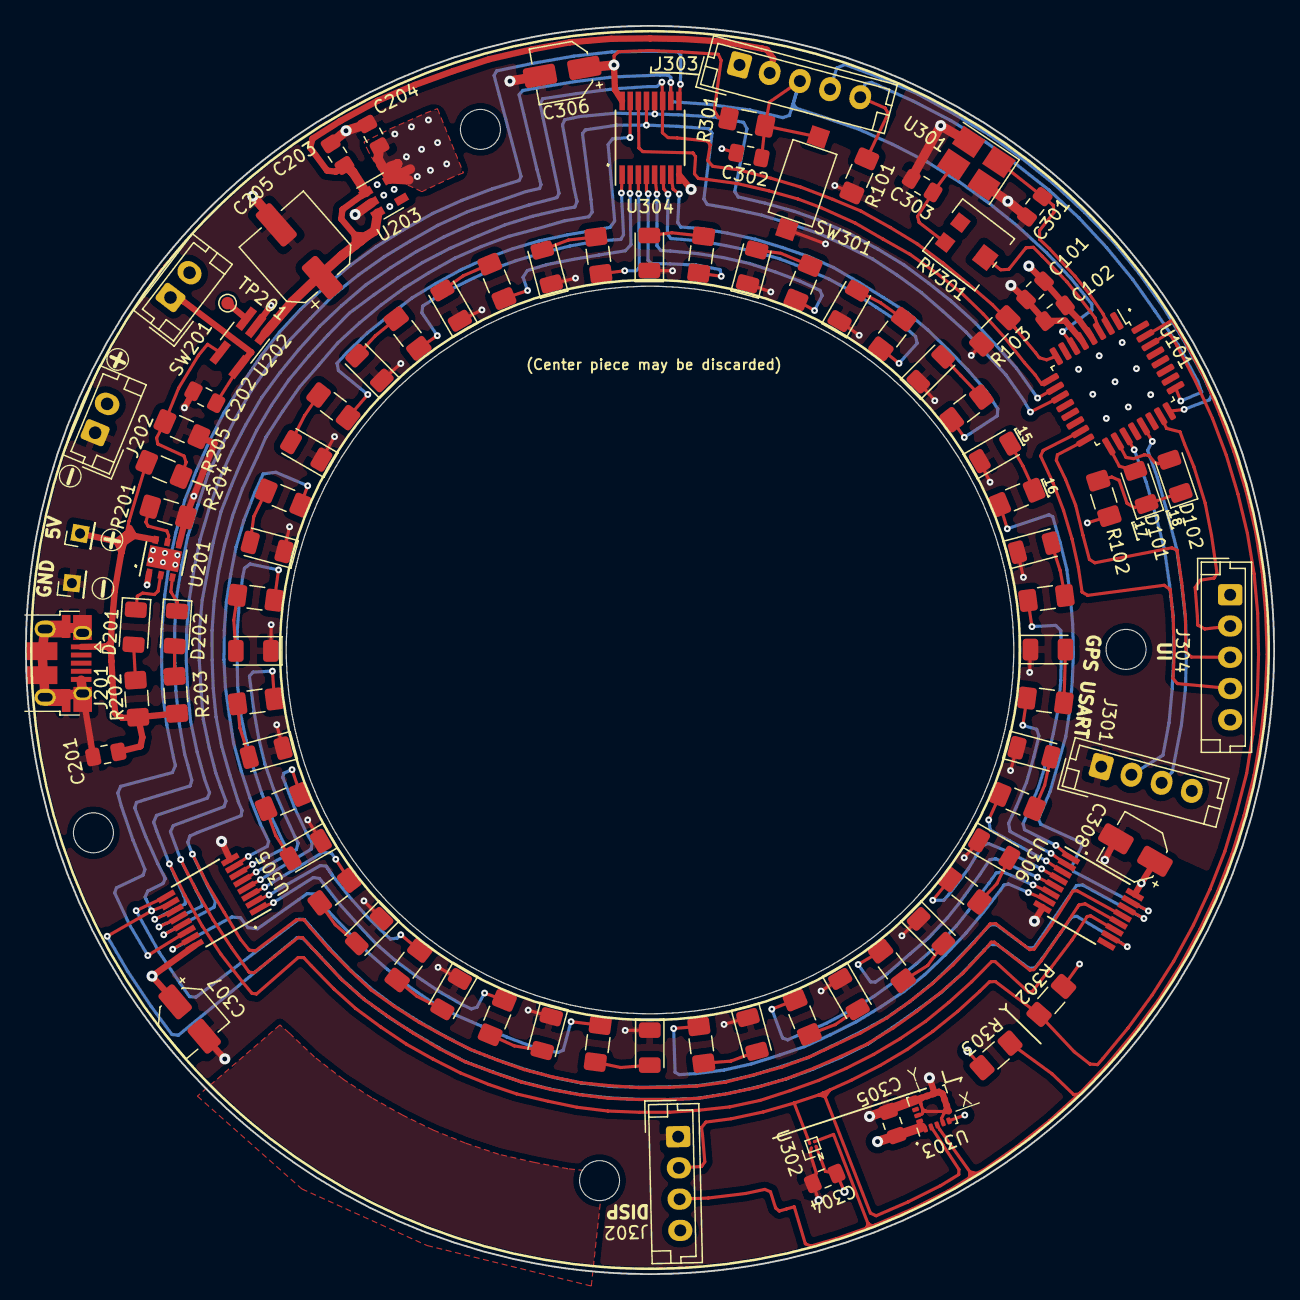
[picture p33: board StarGazer.kicad_pcb from above]

Board: 4 copper layers, 99.9 x 99.9 mm, 104 parts (0 on the bottom side), 83 nets.
