Muellegr/Star_Gazer/Code_2/Code_2/Src/main.c

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
/* Includes ------------------------------------------------------------------*/
#include "main.h"
#include "ring_light_controller.h"
#include "i2c_controller.h"
#include "i2c_gyroscope_lsm6.h"
#include "i2c_magnometer.h"
#include "i2c_display.h"

#include "stdio.h"

/* USER CODE BEGIN PV */
I2C_HandleTypeDef hi2c1;

SPI_HandleTypeDef hspi1;

TIM_HandleTypeDef htim3;

USART_HandleTypeDef husart1;
/* USER CODE END PV */

void SystemClock_Config(void);

static void MX_GPIO_Init(void);

static void MX_I2C1_Init(void);

static void MX_SPI1_Init(void);

static void MX_USART1_Init(void);

static void MX_TIM3_Init(void);
/* USER CODE BEGIN PFP */

//Activates upon interrupt.
void TIM3_Code_Interrupt()
{
	ring_light_controller_tim3_interrupt();
}
/* USER CODE END PFP */

/* USER CODE BEGIN 0 */


/**
  * @brief  The application entry point.
  * @retval int
  */

#include "math.h"
int main(void)
{
	/* MCU Configuration--------------------------------------------------------*/

	/* Reset of all peripherals, Initializes the Flash interface and the Systick. */
	HAL_Init();

	/* Configure the system clock */
	SystemClock_Config();

	/* Initialize all configured peripherals */
	MX_GPIO_Init();
	MX_I2C1_Init();
	MX_SPI1_Init();
	MX_USART1_Init();
	MX_TIM3_Init();
	/* Infinite loop */
	/* USER CODE BEGIN WHILE */
	init_ring_light_controller(&hspi1, &htim3);
	uint32_t loop_int = 0;

	//run_i2c_example();
    HAL_GPIO_WritePin(GPIOA, LED_RED_Pin, RESET);
    chip_led_red_off();


	//Init I2C interfaces
    HAL_Delay(100); //Delay slightly to allow devices to clear
    init_i2c_controller(&hi2c1);
    init_gyroscope();
    init_mag();


    bool result = false;
    gyroscope_orientation_raw orientation_data = {0};
    magnometer_orientation_raw mag_orientation_data = {0};
    volatile gyroscope_orientation_raw orientation_data_diff = {0};
    result = get_gyroscope_orientation( &orientation_data );
    orientation_data_diff = orientation_data;

    int magData_counter = 0;
    int magData_max = 3;
     magnometer_orientation_raw mag_orientation_arr = {0};
    //double direction[1024] = {0};
    //double direction_angle[1024] = {0};


    typedef struct{
        double atan_d;
        double dir;
        double x;
        double y;
        double z;
    } direction_test_type;
    volatile direction_test_type direction[104] = {0};
    volatile float direction_avg = 0.0f;


    display_init();
	while (1)
	{
        //result = get_gyroscope_orientation( &orientation_data );
        //ITM_SEND

        result = get_gyroscope_acceleration( &orientation_data );
       // result = get_magnometer_orientation( &mag_orientation_data );
        if (magData_counter < magData_max)
        {
            get_magnometer_orientation( &mag_orientation_arr);
            double x = mag_orientation_arr.x;
            double y = mag_orientation_arr.y;
            double length = sqrt( x * x + y*y);
            x = x / length;
            y = y / length;

            direction[magData_counter].atan_d = atan2( y, x );
            direction[magData_counter].dir = direction[magData_counter].atan_d * 180.0f / 3.14f;
            direction[magData_counter].x = 1.0f * mag_orientation_arr.x;
            direction[magData_counter].y = 1.0f * mag_orientation_arr.y;
            direction[magData_counter].z = 1.0f * mag_orientation_arr.z;
            magData_counter++;
        }
        else{
            direction_avg = 0;
            double x = 0;
            double y = 0;
            double z = 0;
            double avg_length;
            double avg_dir;

            char str_deg[16] = {' '};
            char str_len[16] = {' '};
            char str_x[16] = {' '};
            char str_y[16] = {' '};


            for (int i = 0 ; i < magData_counter ; ++i ){
                direction_avg += direction[i].dir;
                x += direction[i].x;
                y += direction[i].y;
                z += direction[i].z;
            }
            direction_avg /= magData_counter;
            x = (int) (x / magData_counter);
            y = (int) (y / magData_counter);
            z = (int) (z / magData_counter);
            avg_length = sqrt( (double)(x * x + y*y + z*z));
            avg_dir = atan2(y / avg_length, x / avg_length) * 180.0f / 3.14f;
            if (direction_avg < 0){ direction_avg += 360.0f;}
            magData_counter = 0;

            snprintf(str_deg, 15, "d %f", avg_dir);
            snprintf(str_len, 15, "l %f", avg_length);
            snprintf(str_x, 15, "x %f", x);
            snprintf(str_y, 15, "y %f", y);
            display_4x_string( str_deg, str_len, str_x, str_y );
        }
		loop_int++;
	    if (loop_int % 5 == 0){HAL_GPIO_TogglePin(LED_GREEN_GPIO_Port, LED_GREEN_Pin); }

      //  HAL_GPIO_TogglePin(GPIOA, SWDIO_Pin);
		/* USER CODE END WHILE */
		//HAL_Delay(100);
		/* USER CODE BEGIN 3 */
	}
	/* USER CODE END 3 */
}

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
