Muellegr/Star_Gazer/Code_2/Code_2/Inc/main.h

#define SPI_CLK_SHIFT_REG_Pin GPIO_PIN_1
#define SPI_CLK_SHIFT_REG_GPIO_Port GPIOA
#define SPI_MOSI_SHIFT_REG_DATA_Pin GPIO_PIN_2
#define SPI_MOSI_SHIFT_REG_DATA_GPIO_Port GPIOA
#define SHIFT_REG_LATCH_Pin GPIO_PIN_3
#define SHIFT_REG_LATCH_GPIO_Port GPIOA
#define SHIFT_REG_OUTPUT_ENABLE_N_Pin GPIO_PIN_4
#define SHIFT_REG_OUTPUT_ENABLE_N_GPIO_Port GPIOA
#define UI_JOY_Y_Pin GPIO_PIN_0
#define UI_JOY_Y_GPIO_Port GPIOB
#define UI_JOY_X_Pin GPIO_PIN_1
#define UI_JOY_X_GPIO_Port GPIOB
#define LED_GREEN_Pin GPIO_PIN_2
#define LED_GREEN_GPIO_Port GPIOB
#define LED_RED_Pin GPIO_PIN_8
#define LED_RED_GPIO_Port GPIOA
#define UI_BUTTON_Pin GPIO_PIN_12
#define UI_BUTTON_GPIO_Port GPIOA
