Muellegr/Star_Gazer/Code_2/Code_2/Inc/orientation.h

//
// Created by Graham on 11/5/2020.
//

#ifndef CODE_2_ORIENTATION_H
#define CODE_2_ORIENTATION_H

#include "i2c_gyroscope_lsm6.h"
#include "i2c_magnometer.h"
#include "debug_assert.h"
#endif //CODE_2_ORIENTATION_H
