Muellegr/Star_Gazer/Code_2/Code_2/Inc/debug_assert.h

//
// Created by Graham on 11/2/2020.
//

#ifndef CODE_2_DEBUG_ASSERT_H
#define CODE_2_DEBUG_ASSERT_H

#include "main.h"

void force_assert();
void debug_assert();
bool debug_assert_if( bool b);

#endif //CODE_2_DEBUG_ASSERT_H
