Muellegr/Star_Gazer/(commit log)

2020-08-22 Added current Kicad project.
    [StarGazer.kicad_pcb, StarGazer.sch]
2020-08-23 Continued devolopment -Added battery charging circuit -Added power toggle to prevent over charging battery -Added voltage regulator
    [StarGazer.sch]
2020-08-28 Added screen, gyro, and magnometer. Updated schematic parts.
    [StarGazer.sch]
2020-08-30 Changed linear voltage regulator from 1.7v to 2.8v This is done as I will be removing voltage regulators from some external parts (GPS, screen) and wiring in V_REG directly to them. These usually tak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
    [StarGazer.sch]
2020-09-01 Added oscillator.
    Primary part selection is complete.
    [StarGazer.sch]
2020-09-03 Assigning foot prints and testing GitHub as a site to document project with images.
    [StarGazer.sch]
2020-09-03 Moved major schematic parts to their own sheets - unknown if they have brought about issues because of this. Updated reference IDs.
    [Schematic_Test_Digital.sch, Schematic_Test_Power.sch, StarGazer.sch]
2020-09-04 Corrected some schematic labeling.
    [Schematic_Test_Digital.sch, Schematic_Test_Power.sch, StarGazer.sch]
2020-09-07 Assigned footprints to majority of refs. Missing is i2c due to unknown trace length.
    [Schematic_Test_Digital.sch, Schematic_Test_Power.sch, StarGazer.sch]
2020-09-08 Continued (slow) devolopment.
    PCB board has begun. Parts are pushed out to where they need to roughly be.
    [Schematic_Test_Digital.sch, StarGazer.kicad_pcb, StarGazer.sch]
2020-09-08 "PREVIOUS COMMIT MAIN SCHEMATIC CORRUPTED (???). Used commit before that."
    [Schematic_Test_Digital.sch, StarGazer.sch]
2020-09-08 End of night, progress continues.
    Parts are getting initial placement.
    confidence raises.
    [Schematic_Test_Digital.sch, StarGazer.kicad_pcb]
2020-09-09 Switching magnometer with an updated part. This change is due to the limitations of JLCPCB's ball grid array. The ball diameter is 0.25mm, while the component has 0.2 While this could probably be wor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
    It is twice the cost of the orignal part and requires more support components, but is otherwhys an upgrade.
    [StarGazer.kicad_pcb]
2020-09-09 Updated magnometer to LIS3MDL which has a more sane footprint.
    [Schematic_Test_Digital.sch, StarGazer.kicad_pcb]
2020-09-09 Discovered small bug with BoM script. It does not acccount for all parameters, such as foot print. This resulted in it thinking a electro-cap could be a ceramic-cap since they shared the same value.
    To simplify parts, C310 is now a ceramic cap at the same value.
    [Schematic_Test_Digital.sch, StarGazer.kicad_pcb]
2020-09-10 Preparing to begin placing parts on actual PCB
    [StarGazer.kicad_pcb]
2020-09-11 Center LED ring laid out and connected. Other components will begin to be fitted into place. Silk screen has not been touched.
    [Schematic_Test_Digital.sch, StarGazer.kicad_pcb, StarGazer.sch]
2020-09-13 Many parts are now placed on PCB.
    Work left off on MC, gyro, and mag.
    Discovered free-angle mode for traces, which will make connections look better in the future.
    [Schematic_Test_Digital.sch, Schematic_Test_Power.sch, StarGazer.kicad_pcb]
2020-09-14 All parts on board and routed. Beginning final part compatibility check. Big TODO is select GPS, verify parts, and begin route-polish step.
    [Schematic_Test_Digital.sch, StarGazer.kicad_pcb]
2020-09-15 Calculating ram needed and current selected chip will not fit it. Upgrading to a more capable chip.
    [Schematic_Test_Digital.sch, Schematic_Test_Power.sch, StarGazer.kicad_pcb, StarGazer.sch]
2020-09-16 Upgraded to STM32G0 for increased memory. Schematic and PCB are updated. PCB now has radial grid applied in preparation of final part placement.
    [Schematic_Test_Digital.sch, StarGazer.kicad_pcb, StarGazer.sch]
2020-09-16 Shift register tracing remade to curved. Hand hurty
    [StarGazer.kicad_pcb, StarGazer.sch]
2020-09-17 PCB updated to curved traces. Leftover final polish, screw locations, drill-routing, and art is missing
    [Schematic_Test_Power.sch, StarGazer.kicad_pcb, StarGazer.sch]
2020-09-18 Added screw locations.
    [StarGazer.kicad_pcb]
2020-09-21 Continued work on PCB. Added back art.
    [Schematic_Test_Digital.sch, Schematic_Test_Power.sch, StarGazer.kicad_pcb, StarGazer.sch]
2020-09-23 Working on case. Base cutouts took time but should now be complete. Height from top to bottom of 50mm.
2020-09-25 PCB is likely complete. Added USART for GPS. Added background art and front label. Some leftover things are needed for the case.
    [Schematic_Test_Digital.sch, StarGazer.kicad_pcb, StarGazer.sch]
2020-09-28 Purchases made, case ordered, PCB ordered, parts ordered, money not happy.
    [Schematic_Test_Digital.sch, Schematic_Test_Power.sch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]
2020-09-30 Added proper file locations for schematic and pcb views
2020-10-07 Added case pictures
2020-10-15 Added images. Small schematic corrections
    [Schematic_Test_Power.sch, StarGazer.kicad_pcb]
2020-11-06 Added code repo. Intention is to remove Hal drivers and write my own at some point. For now, let's have the code backed up while I work on it...
    [stm32f3discovery.cfg]
2020-11-09 Debugging on magnometer, believe the device is broken due to readings. Screen is set to debug
    [RingLight.c, RingLight.h, i2c_controller.c, i2c_controller.h, i2c_display.c, i2c_display.h, i2c_gyroscope_lsm6.c, i2c_magnometer.c]
