Muellegr/Star_Gazer/Documentation/Images/PCB running/IMG_20201013_093149.jpg

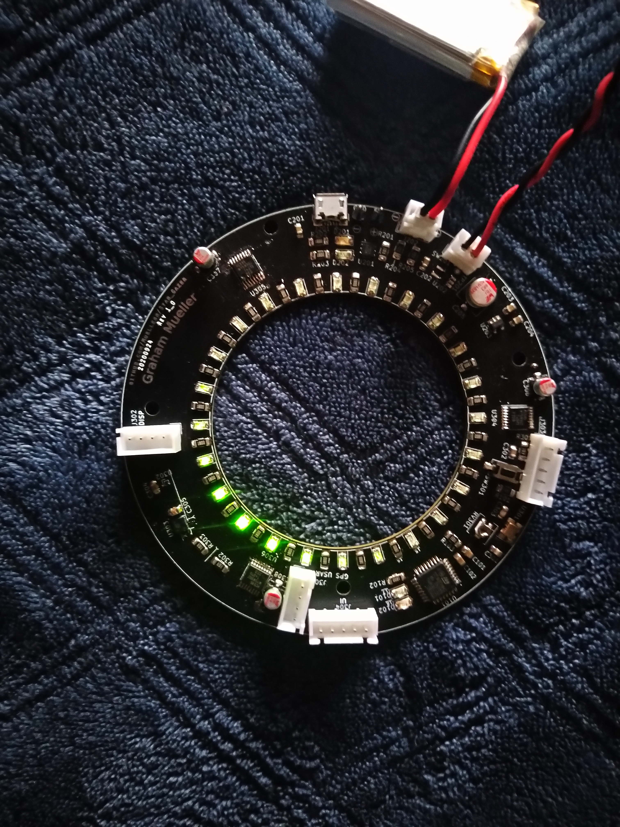
Documentation/Images/PCB running/IMG_20201013_093149.jpg
